esl-epfl/VersaSens/VersaSens_Casing/Design_Compact/Description_Design_Compact.txt

CAD design for the compact casing as STP and STL files.

Recommendation for 3D printing:
- Resolution: 0.15mm
- PLA material
- support on bed only
- Front part on the front face
- Back part on the back face and with an opened latch at 60°.
