esl-epfl/VersaSens/VersaSens_Casing/Design_Distributed/Main_front.stl

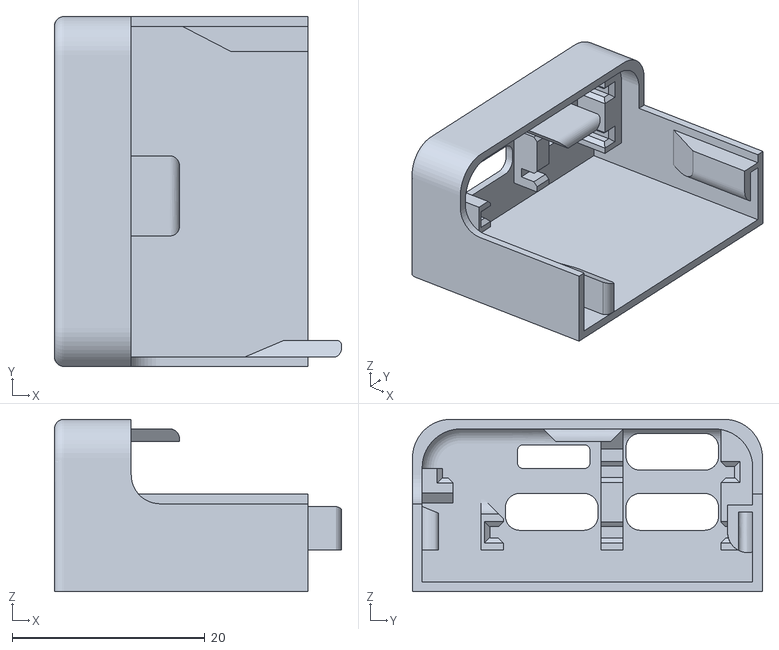
[picture p1: CAD file, 2024-08-30]
VersaSens_Casing/Design_Distributed/Main_front.stl
29.8 x 36.3 x 17.9
