esl-epfl/VersaSens/VersaSens_Casing/Design_Distributed/main_back_latch.stl

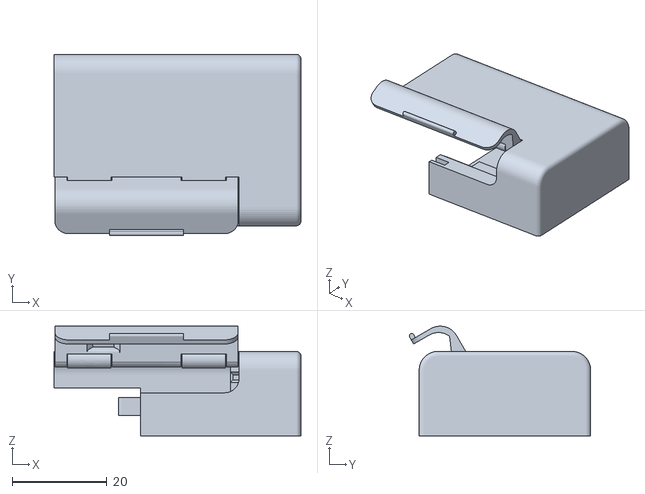
[picture p2: CAD file, 2024-08-30]
VersaSens_Casing/Design_Distributed/main_back_latch.stl
52.2 x 38.4 x 23.2
