esl-epfl/VersaSens/VersaSens_Casing/Design_Compact/VersaSens_Design_Compact_front.stl

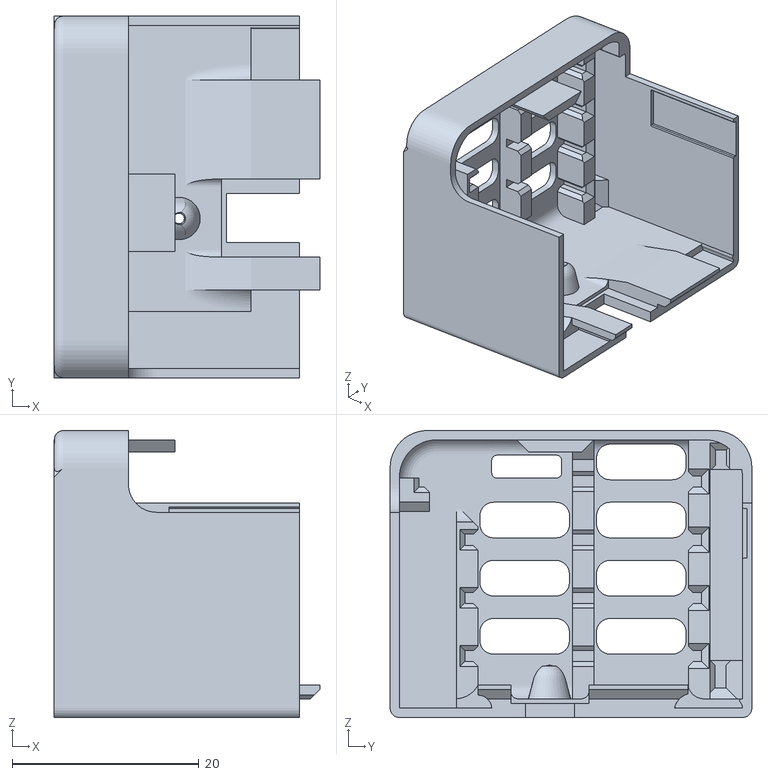
[picture p3: CAD file, 2024-08-30]
VersaSens_Casing/Design_Compact/VersaSens_Design_Compact_front.stl
28.5 x 38.8 x 30.8
