esl-epfl/VersaSens/VersaSens_HW/symbols/BM02B-ACHSS-GAN-TF_LF__SN_/BM02B-ACHSS-GAN-TF_LF__SN_.step

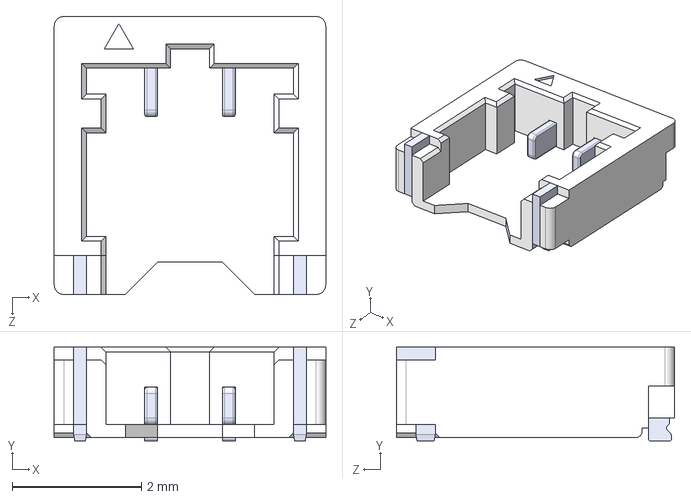
[picture p4: CAD file, 2024-08-30]
VersaSens_HW/symbols/BM02B-ACHSS-GAN-TF_LF__SN_/BM02B-ACHSS-GAN-TF_LF__SN_.step
4.20 x 1.45 x 4.30 mm
