esl-epfl/VersaSens/VersaSens_HW/symbols/USB4055-30-A/USB4055-30-A.step

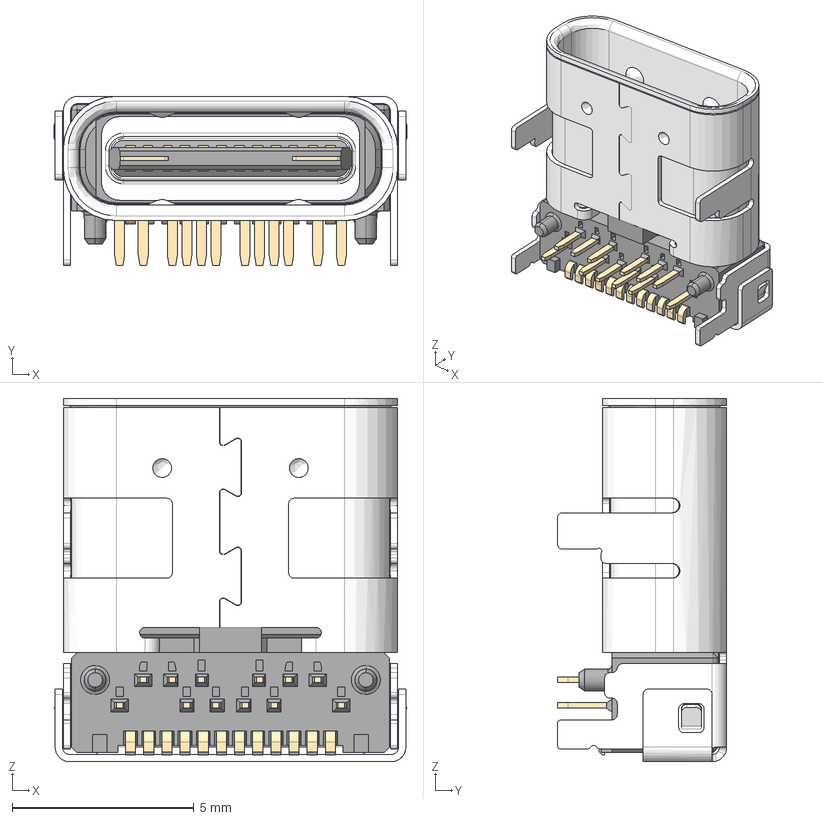
[picture p5: CAD file, 2024-08-30]
VersaSens_HW/symbols/USB4055-30-A/USB4055-30-A.step
9.71 x 4.66 x 10.0 mm
