esl-epfl/VersaSens/VersaSens_Casing/Design_Compact/VersaSens_Design_Compact_back_latch.stl

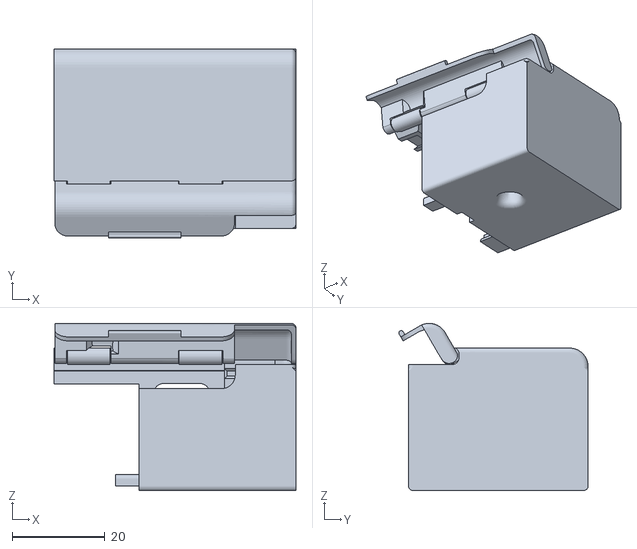
[picture p6: CAD file, 2024-08-30]
VersaSens_Casing/Design_Compact/VersaSens_Design_Compact_back_latch.stl
52.2 x 40.9 x 36.1
