esl-epfl/VersaSens/VersaSens_Casing/Design_Compact/VersaSens_Design_Compact.step

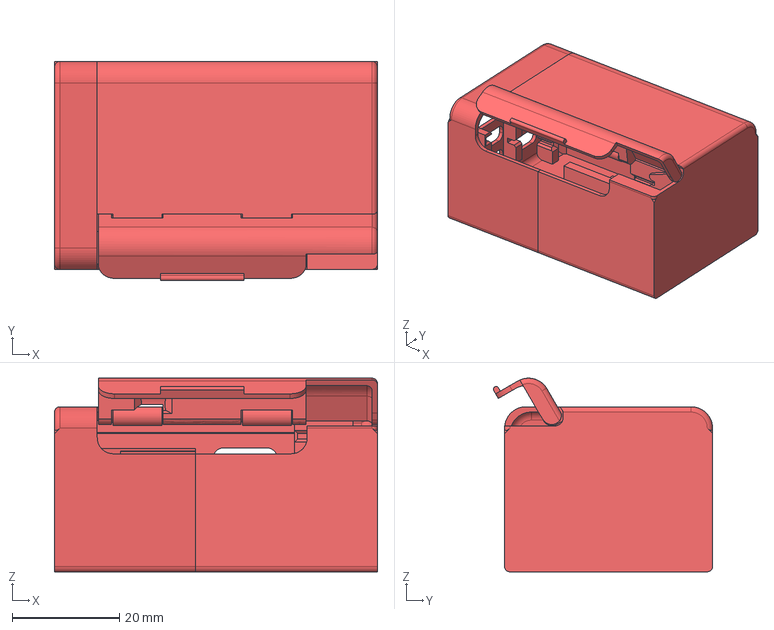
[picture p7: CAD file, 2024-08-30]
VersaSens_Casing/Design_Compact/VersaSens_Design_Compact.step
60.2 x 40.9 x 36.1 mm
Frame1
Frame2
