esl-epfl/VersaSens/VersaSens_Casing/Design_Distributed/VersaSens_Design_Distributed_.step

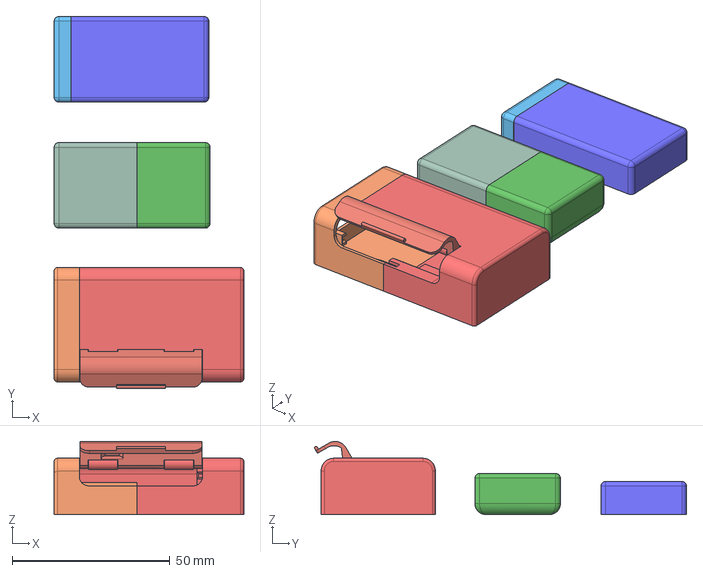
[picture p8: CAD file, 2024-08-30]
VersaSens_Casing/Design_Distributed/VersaSens_Design_Distributed_.step
60.2 x 118.1 x 23.2 mm
