esl-epfl/VersaSens/VersaSens_Casing/Design_Distributed/PPG_back.stl

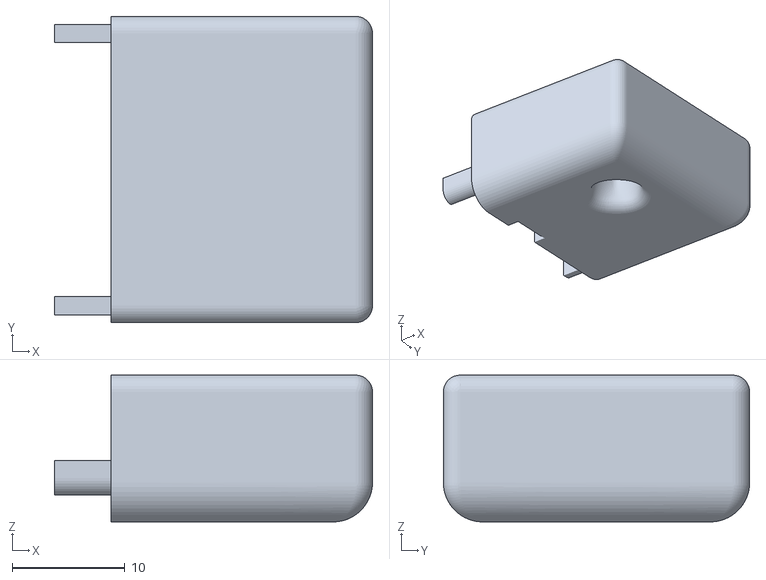
[picture p9: CAD file, 2024-08-30]
VersaSens_Casing/Design_Distributed/PPG_back.stl
28.2 x 27.2 x 13.0
