esl-epfl/VersaSens/VersaSens_Casing/Design_Distributed/EDA_back.stl

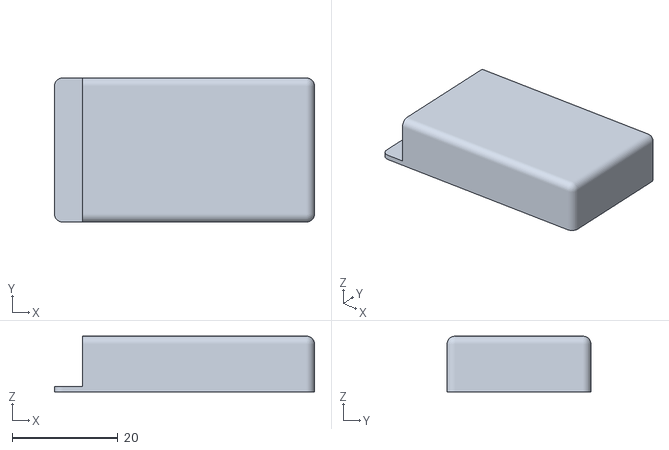
[picture p10: CAD file, 2024-08-30]
VersaSens_Casing/Design_Distributed/EDA_back.stl
49.1 x 27.2 x 10.5
