esl-epfl/VersaSens/VersaSens_Casing/Design_Distributed/PPG_front.stl

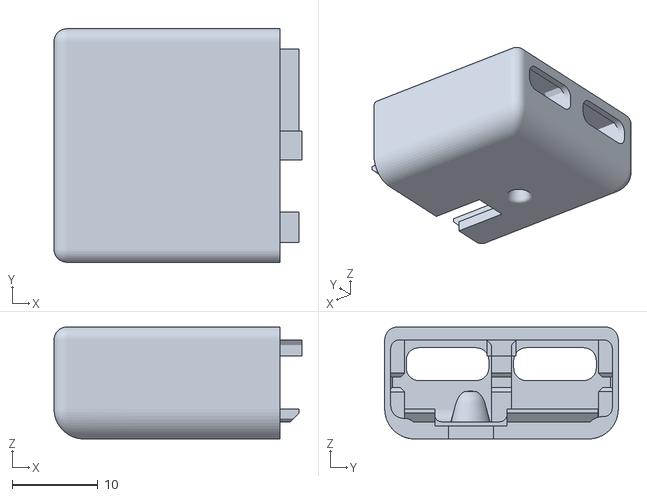
[picture p11: CAD file, 2024-08-30]
VersaSens_Casing/Design_Distributed/PPG_front.stl
28.8 x 27.2 x 13.0
