esl-epfl/VersaSens/VersaSens_Casing/Design_Distributed/EDA_front.stl

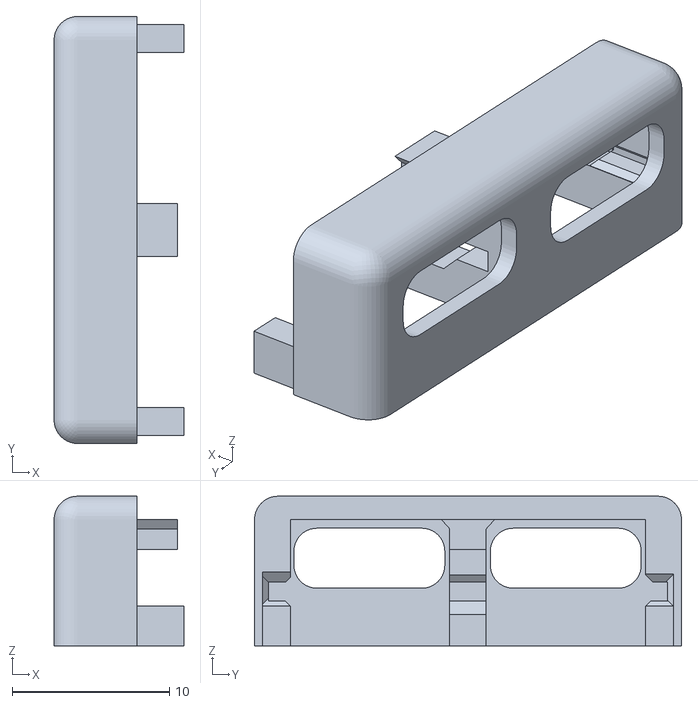
[picture p12: CAD file, 2024-08-30]
VersaSens_Casing/Design_Distributed/EDA_front.stl
8.27 x 27.2 x 9.53
