esl-epfl/VersaSens/VersaSens_HW/symbols/47589-0001/47589-0001.step

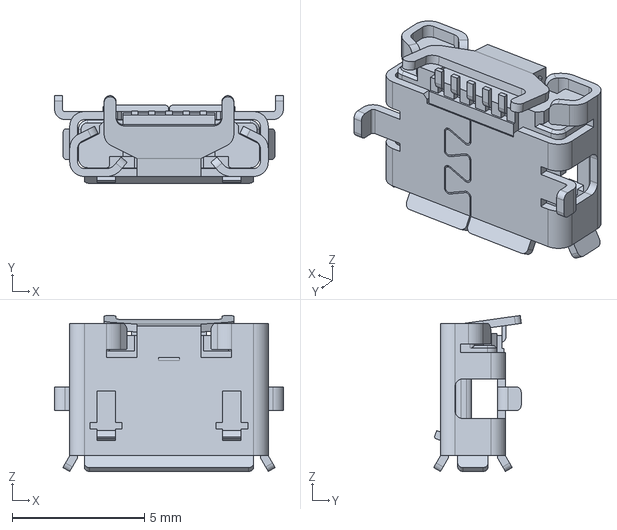
[picture p13: CAD file, 2024-08-30]
VersaSens_HW/symbols/47589-0001/47589-0001.step
8.65 x 3.31 x 5.89 mm
