esl-epfl/VersaSens/(threads)

Thread 2 (2024-09-06):

Main-Module_MAX77658BANX+T

JoseCalero, 2024-09-06:
Problem: MAX77658BANX+T has the SBB2 off by default. SBB2 is the main supply (3.3V) of the board. SBB2 can be activated changing register EN_SBB2 of MAX77658BANX+T by nRF5340. But the nRF5340 is supplied by the SBB2.

Temporary solution: A jumper to be applied on the board from C6 (V-SYS) to pin1 of IC3. Once the microcontroller is supplied, the ADE_SBB2 register should be disabled from the software (ADE_SBB2 = 0b0) to disable the discharge resistors on the SBB2.

Picture:
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
