esl-epfl/VersaSens/VersaSens_HW/ECG_PPG.kicad_sch

## KiCad design VersaSens_HW/ECG_PPG.kicad_sch (2024-08-30)

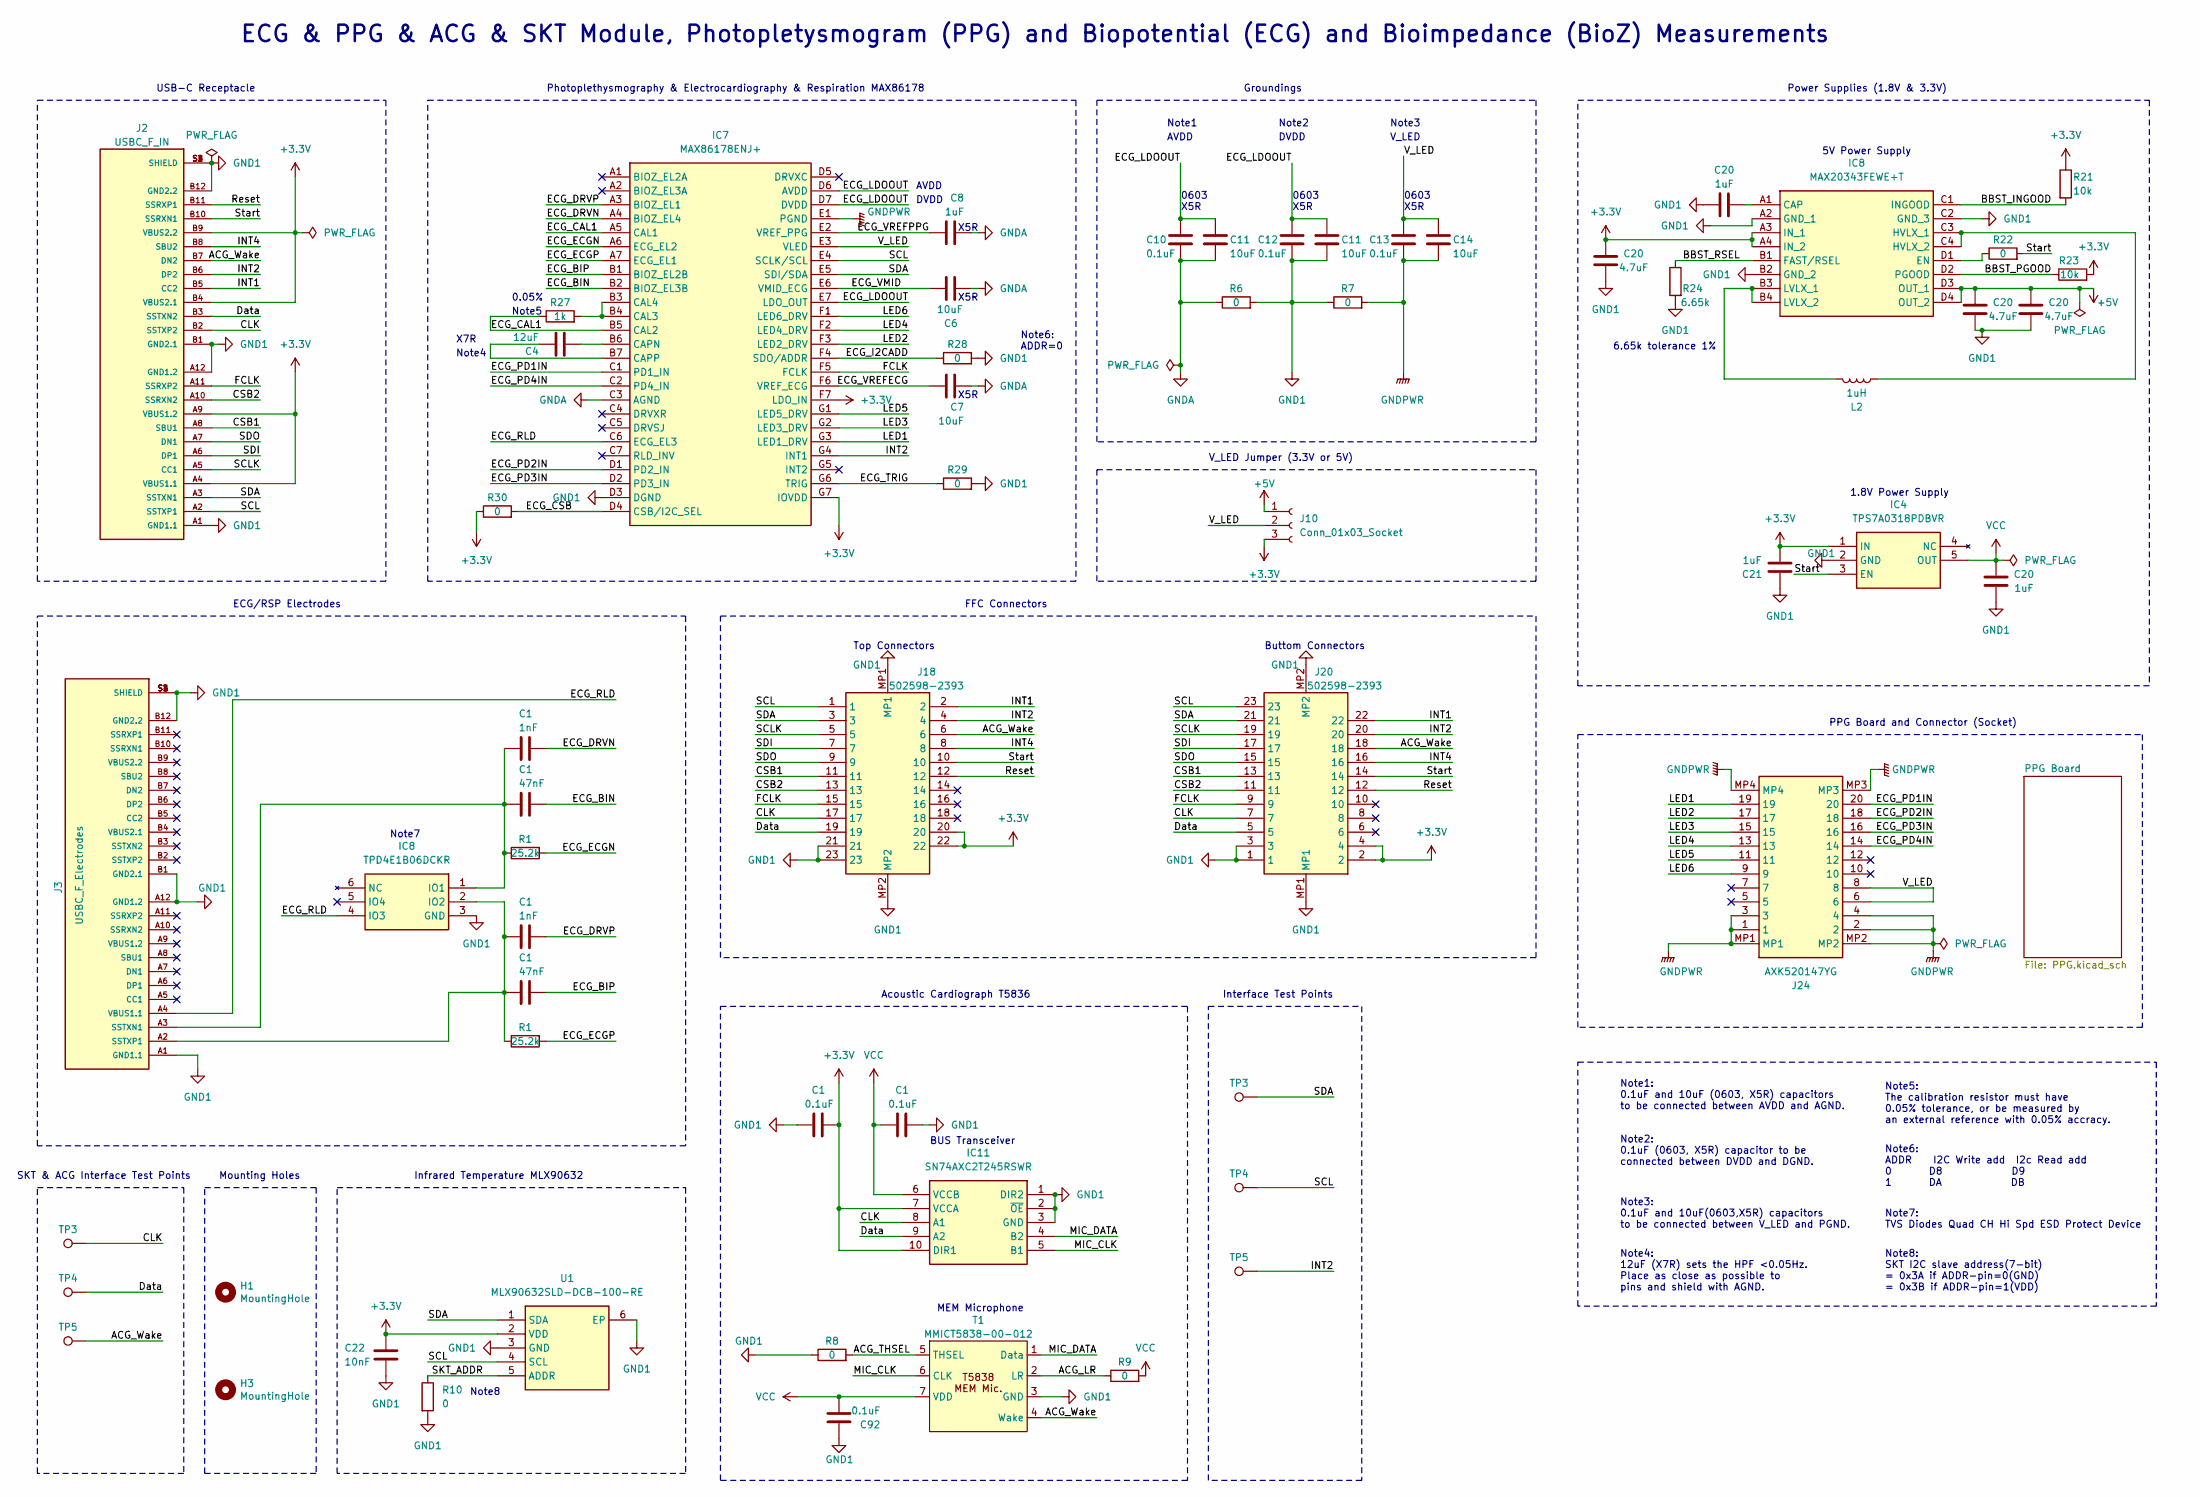
[picture p14: schematic ECG_PPG.kicad_sch]

Parts:
C1: 1nF; C_0603_1608Metric
C4: 12uF; C_1210_3225Metric
C6, C7, C11, C14: 10uF; C_0603_1608Metric
C8: 1uF; C_0603_1608Metric
C10, C12, C13: 0.1uF; C_0603_1608Metric
C20: 4.7uF; C_0402_1005Metric
C21: 1uF; C_0402_1005Metric
C22: 10nF; C_0603_1608Metric
C92: 0.1uF; C_0402_1005Metric
H1, H3: MountingHole; MountingHole_2.5mm
IC4: TPS7A0318PDBVR; SOT95P280X145-5N; Mouser Part Number 595-TPS7A0318PDBVR
IC7: MAX86178ENJ+; 21-100520_N492A2&plus_1_MXM; Manufacturer_Part_Number MAX86178ENJ+; Mouser Part Number N/A
IC8: MAX20343FEWE+T; BGA16C40P4X4_201X177X69; Manufacturer_Part_Number MAX20343FEWE+T; Mouser Part Number 700-MAX20343FEWE+T
IC11: SN74AXC2T245RSWR; Mouser Part Number 595-SN74AXC2T245RSWR
J2: USBC_F_IN; GCT_USB4055-30-A; PARTREV B; DIGI-KEY_PART_NUMBER 2073-USB4055-30-ACT-ND
J3: USBC_F_Electrodes; GCT_USB4055-30-A; PARTREV B; DIGI-KEY_PART_NUMBER 2073-USB4055-30-ACT-ND
J10: Conn_01x03_Socket; HDRV3W40P0X127_1X3_381X210X430P
J18, J20: 502598-2393; 5025982393; Mouser Part Number 538-502598-2393
J24: AXK520147YG; Mouser Part Number 769-AXK520147YG
L2: 1uH; LQM21PN1R0MEHD
R1: 25.2k; R_0402_1005Metric
R6, R7, R8, R9, R10, R22, R28, R29, R30: 0; R_0402_1005Metric
R21, R23: 10k; R_0402_1005Metric
R24: 6.65k; R_0402_1005Metric
R27: 1k; R_0402_1005Metric
T1: MMICT5838-00-012; LGA_CAV5_IVS
TP3, TP4, TP5: TestPoint; TestPoint_Pad_D1.0mm
U1: MLX90632SLD-DCB-100-RE; MLX90632SLDDCB100RE; Manufacturer_Part_Number MLX90632SLD-DCB-100-RE; Mouser Part Number 482-90632SLDDCB100RE

Connections:
+3.3V: C1.1, C20.1, C21.2, C22.1, IC4.1 (IN), IC7.F7 (LDO_IN), IC7.G7 (IOVDD), IC8.A3 (IN_1), IC8.A4 (IN_2), IC11.7 (VCCA), IC11.10 (DIR1), J2.A4 (VBUS1.1), J2.A9 (VBUS1.2), J2.B4 (VBUS2.1), J2.B9 (VBUS2.2), J10.3, J18.20, J18.22, J20.2, J20.4, R21.1, R23.2, R30.1, U1.2 (VDD)
+5V: C20.1, IC8.D3 (OUT_1), IC8.D4 (OUT_2), J10.1
ACG_LR: R9.1, T1.2 (LR)
ACG_THSEL: R8.2, T1.5 (THSEL)
ACG_Wake: J2.B7 (DN2), J18.6, J20.18, T1.4 (Wake), TP5.1
BBST_INGOOD: IC8.C1 (INGOOD), R21.2
BBST_PGOOD: IC8.D2 (PGOOD), R23.1
BBST_RSEL: IC8.B1 (FAST/RSEL), R24.1
CLK: IC11.8 (A1), J2.B2 (SSTXP2), J18.17, J20.7, TP3.1
CSB1: J2.A8 (SBU1), J18.11, J20.13
CSB2: J2.A10 (SSRXN2), J18.13, J20.11
Data: IC11.9 (A2), J2.B3 (SSTXN2), J18.19, J20.5, TP4.1
ECG_BIN: C1.1, IC7.B2 (BIOZ_EL3B)
ECG_BIP: C1.1, IC7.B1 (BIOZ_EL2B)
ECG_CAL1: IC7.A5 (CAL1), IC7.B5 (CAL2), R27.1
ECG_CSB: IC7.D4 (CSB/I2C_SEL), R30.2
ECG_DRVN: C1.1, IC7.A4 (BIOZ_EL4)
ECG_DRVP: C1.1, IC7.A3 (BIOZ_EL1)
ECG_ECGN: IC7.A6 (ECG_EL2), R1.2
ECG_ECGP: IC7.A7 (ECG_EL1), R1.2
ECG_I2CADD: IC7.F4 (SDO/ADDR), R28.1
ECG_LDOOUT: C10.1, C11.1, C12.1, IC7.D6 (AVDD), IC7.D7 (DVDD), IC7.E7 (LDO_OUT)
ECG_PD1IN: IC7.C1 (PD1_IN), J24.20
ECG_PD2IN: IC7.D1 (PD2_IN), J24.18
ECG_PD3IN: IC7.D2 (PD3_IN), J24.16
ECG_PD4IN: IC7.C2 (PD4_IN), J24.14
ECG_RLD: IC7.C6 (ECG_EL3), IC8.4 (IO3), J3.A4 (VBUS1.1)
ECG_TRIG: IC7.G6 (TRIG), R29.1
ECG_VMID: C6.2, IC7.E6 (VMID_ECG)
ECG_VREFECG: C7.1, IC7.F6 (VREF_ECG)
ECG_VREFPPG: C8.1, IC7.E2 (VREF_PPG)
FCLK: IC7.F5 (FCLK), J2.A11 (SSRXP2), J18.15, J20.9
GND1: C1.1, C1.2, C11.2, C12.2, C20.2, C21.1, C22.2, C92.2, IC4.2 (GND), IC7.D3 (DGND), IC8.3 (GND), IC8.A2 (GND_1), IC8.B2 (GND_2), IC8.C2 (GND_3), IC11.1 (DIR2), IC11.2 (~OE), IC11.3 (GND), J2.A1 (GND1.1), J2.A12 (GND1.2), J2.B1 (GND2.1), J2.B12 (GND2.2), J2.S1 (SHIELD), J2.S2 (SHIELD), J2.S3 (SHIELD), J2.S4 (SHIELD), J3.A1 (GND1.1), J3.A12 (GND1.2), J3.B1 (GND2.1), J3.B12 (GND2.2), J3.S1 (SHIELD), J3.S2 (SHIELD), J3.S3 (SHIELD), J3.S4 (SHIELD), J18.21, J18.23, J18.MP1, J18.MP2, J20.1, J20.3, J20.MP1, J20.MP2, R6.2, R7.1, R8.1, R10.2, R24.2, R28.2, R29.2, T1.3 (GND), U1.3 (GND), U1.6 (EP)
GNDA: C6.1, C7.2, C8.2, C10.2, C11.2, IC7.C3 (AGND), R6.1
GNDPWR: C13.2, C14.2, IC7.E1 (PGND), J24.1, J24.2, J24.3, J24.4, J24.MP1, J24.MP2, J24.MP3, J24.MP4, R7.2
INT1: J2.B5 (CC2), J18.2, J20.22
INT2: IC7.G4 (INT1), J2.B6 (DP2), J18.4, J20.20, TP5.1
INT4: J2.B8 (SBU2), J18.8, J20.16
LED1: IC7.G3 (LED1_DRV), J24.19
LED2: IC7.F3 (LED2_DRV), J24.17
LED3: IC7.G2 (LED3_DRV), J24.15
LED4: IC7.F2 (LED4_DRV), J24.13
LED5: IC7.G1 (LED5_DRV), J24.11
LED6: IC7.F1 (LED6_DRV), J24.9
MIC_CLK: IC11.5 (B1), T1.6 (CLK)
MIC_DATA: IC11.4 (B2), T1.1 (Data)
unnamed: C1.2, IC8.1 (IO1), IC8.2 (IO2), J3.A2 (SSTXP1), J3.A3 (SSTXN1), R1.1
unnamed: C4.1, IC7.B7 (CAPP)
unnamed: C4.2, IC7.B6 (CAPN)
unnamed: C20.1, IC8.A1 (CAP)
unnamed: IC7.B3 (CAL4), IC7.B4 (CAL3), R27.2
unnamed: IC8.B3 (LVLX_1), IC8.B4 (LVLX_2), L2.1
unnamed: IC8.C3 (HVLX_1), IC8.C4 (HVLX_2), L2.2
unnamed: IC8.D1 (EN), R22.1
Reset: J2.B11 (SSRXP1), J18.12, J20.12
SCL: IC7.E4 (SCLK/SCL), J2.A2 (SSTXP1), J18.1, J20.23, TP4.1, U1.4 (SCL)
SCLK: J2.A5 (CC1), J18.5, J20.19
SDA: IC7.E5 (SDI/SDA), J2.A3 (SSTXN1), J18.3, J20.21, TP3.1, U1.1 (SDA)
SDI: J2.A6 (DP1), J18.7, J20.17
SDO: J2.A7 (DN1), J18.9, J20.15
SKT_ADDR: R10.1, U1.5 (ADDR)
Start: IC4.3 (EN), J2.B10 (SSRXN1), J18.10, J20.14, R22.2
VCC: C1.2, C20.1, C92.1, IC4.5 (OUT), IC11.6 (VCCB), R9.2, T1.7 (VDD)
V_LED: C13.1, C14.1, IC7.E3 (VLED), J10.2, J24.6, J24.8

Notes on the sheet:
X5R
Interface Test Points
Note8
Note5: The calibration resistor must have 0.05% tolerance, or be measured by an external reference with 0.05% accracy.
6.65k tolerance 1%
ECG/RSP Electrodes
V_LED
Note3: 0.1uF and 10uF(0603,X5R) capacitors to be connected between V_LED and PGND.
Note6: ADDR=0
Photoplethysmography & Electrocardiography & Respiration MAX86178
0603 X5R
BUS Transceiver
Note4
Note8: SKT I2C slave address(7-bit) = 0x3A if ADDR-pin=0(GND) = 0x3B if ADDR-pin=1(VDD)
Note2
AVDD
Top Connectors
V_LED Jumper (3.3V or 5V)
SKT & ACG Interface Test Points
MEM Microphone
Note7: TVS Diodes Quad CH Hi Spd ESD Protect Device
Note1: 0.1uF and 10uF (0603, X5R) capacitors to be connected between AVDD and AGND.
USB-C Receptacle
Infrared Temperature MLX90632
ECG & PPG & ACG & SKT Module, Photopletysmogram (PPG) and Biopotential (ECG) and Bioimpedance (BioZ) Measurements
1.8V Power Supply
Note7
Note5
Note1
DVDD
Buttom Connectors
FFC Connectors
0.05%
Note4: 12uF (X7R) sets the HPF <0.05Hz. Place as close as possible to pins and shield with AGND.
Groundings
Power Supplies (1.8V & 3.3V)
Note2: 0.1uF (0603, X5R) capacitor to be connected between DVDD and DGND.
5V Power Supply
Note6: ADDR I2C Write add I2c Read add 0 D8 D9 1 DA DB
Mounting Holes
Acoustic Cardiograph T5836
Note3
PPG Board and Connector (Socket)
X7R
