esl-epfl/VersaSens/VersaSens_HW/EDA.kicad_sch

## KiCad design VersaSens_HW/EDA.kicad_sch (2024-08-30)

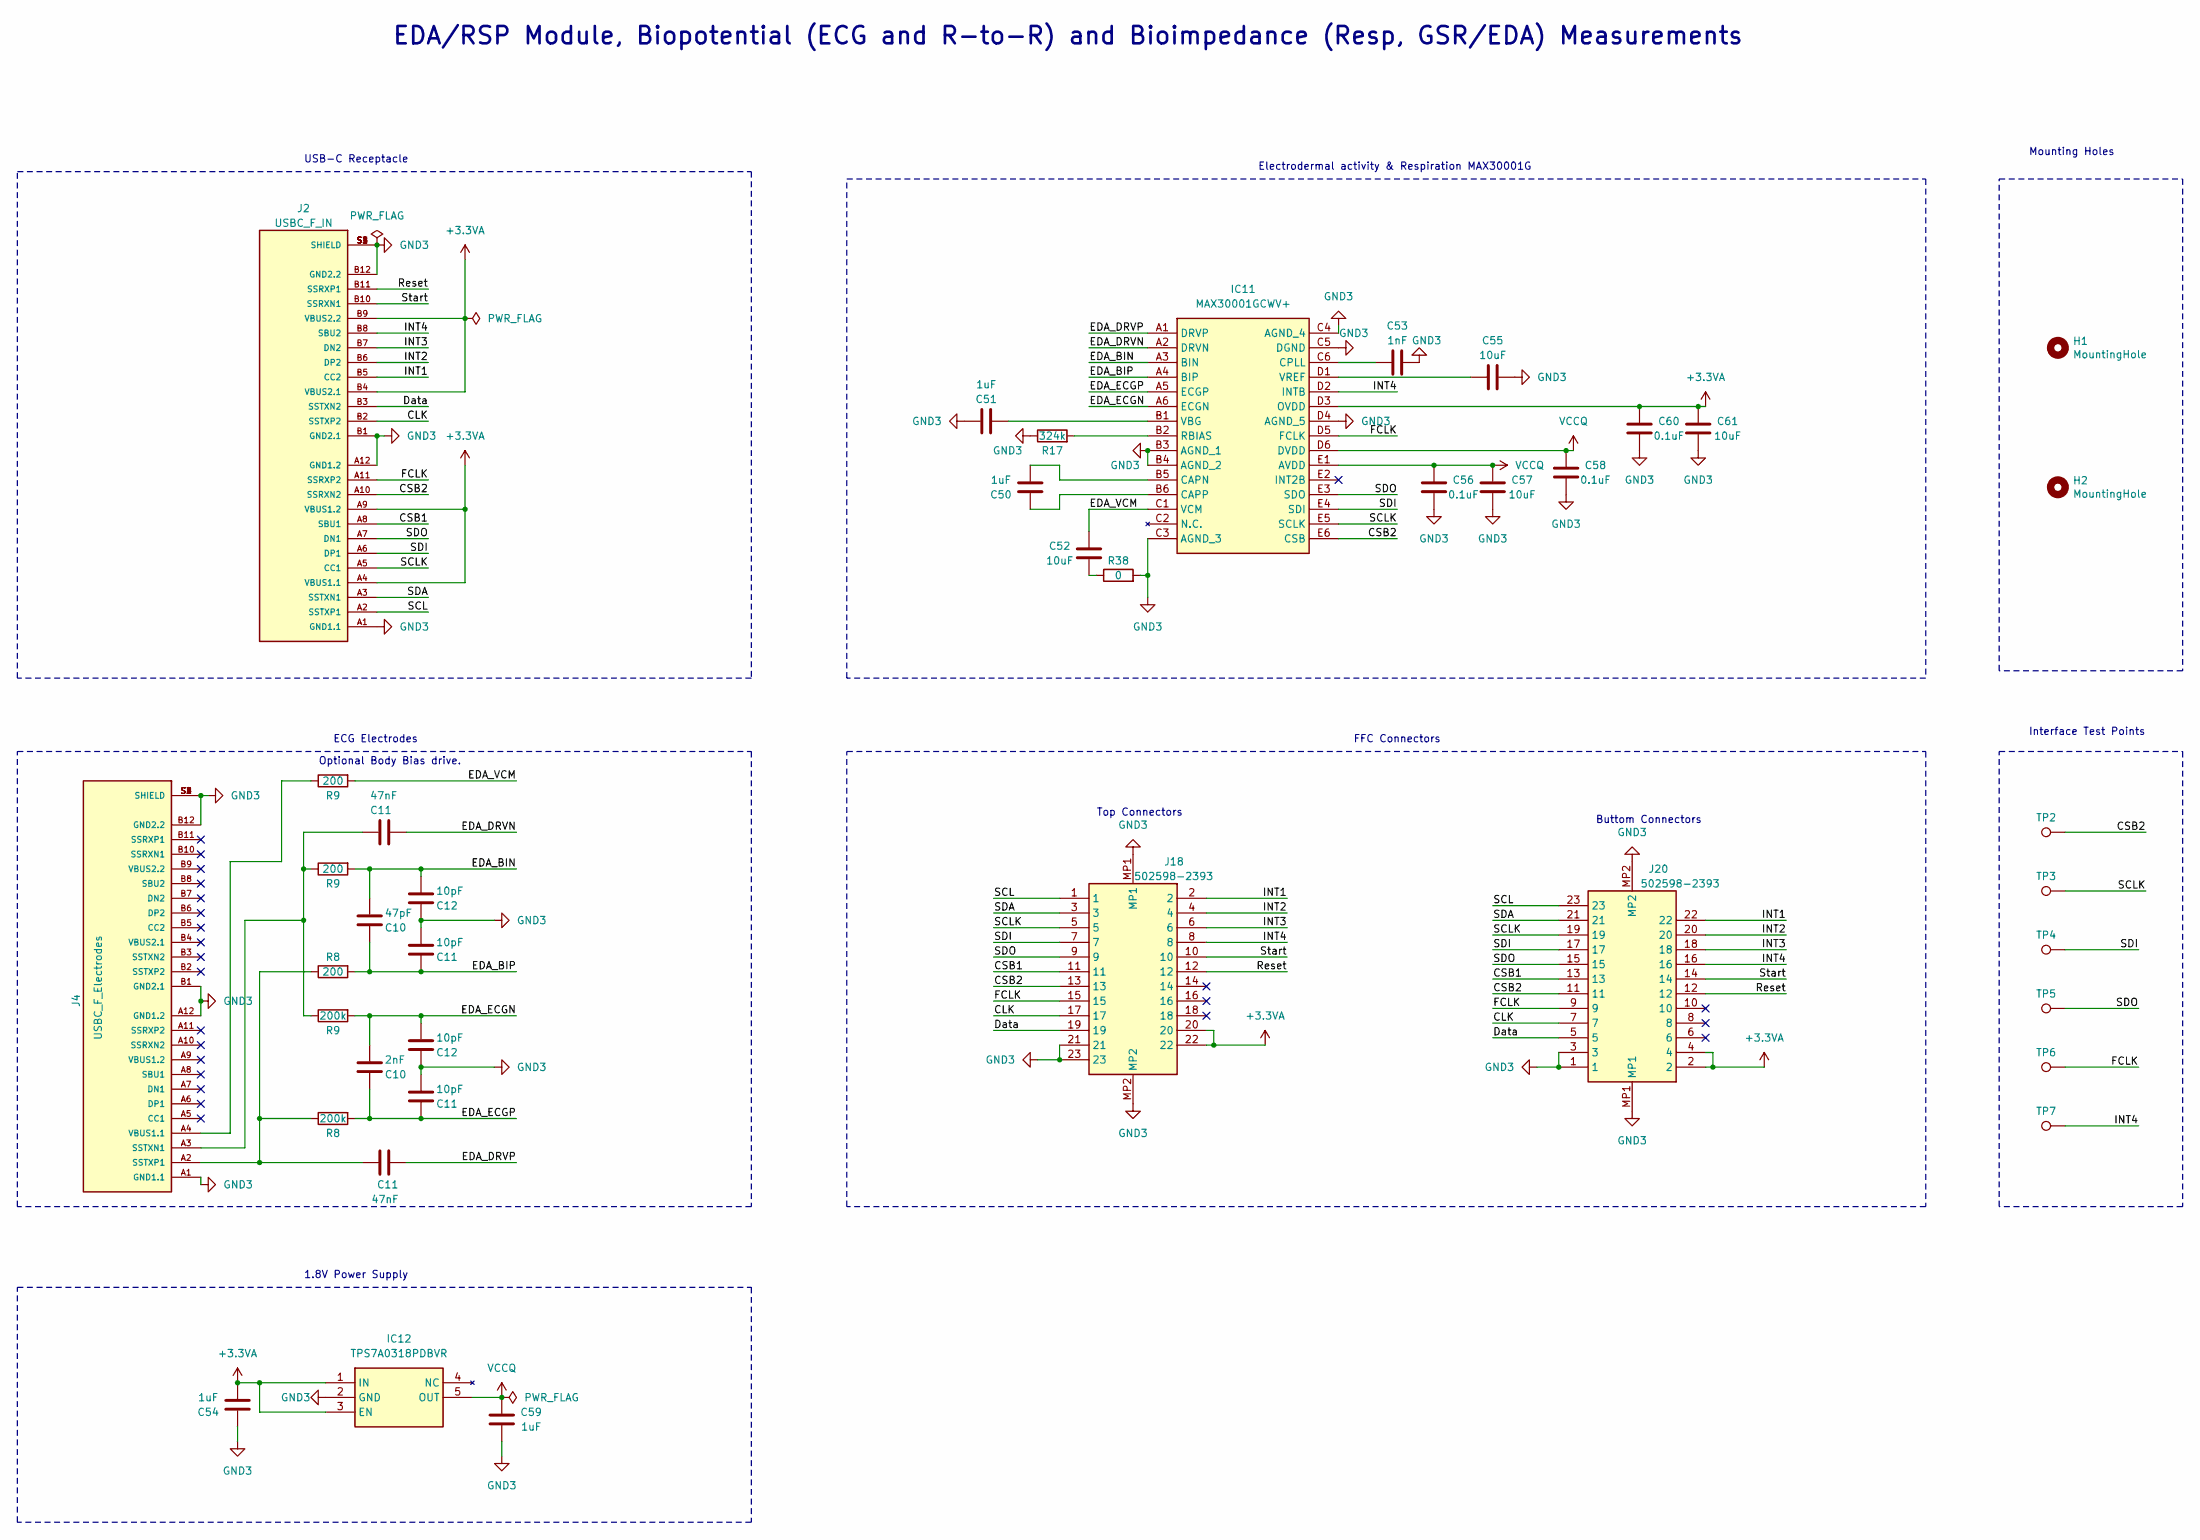
[picture p15: schematic EDA.kicad_sch]

Parts:
C10: 47pF; C_0603_1608Metric
C11, C12: 10pF; C_0603_1608Metric
C50, C51, C54, C59: 1uF; C_0402_1005Metric
C52, C55, C57, C61: 10uF; C_0603_1608Metric
C53: 1nF; C_0402_1005Metric
C56, C58, C60: 0.1uF; C_0402_1005Metric
H1, H2: MountingHole; MountingHole_2.5mm
IC11: MAX30001GCWV+; BGA30C50P6X5_293X274X69; Manufacturer_Part_Number MAX30001GCWV+; Mouser Part Number 700-MAX30001GCWV+
IC12: TPS7A0318PDBVR; SOT95P280X145-5N; Mouser Part Number 595-TPS7A0318PDBVR
J2: USBC_F_IN; GCT_USB4055-30-A; PARTREV B; DIGI-KEY_PART_NUMBER 2073-USB4055-30-ACT-ND
J4: USBC_F_Electrodes; GCT_USB4055-30-A; PARTREV B; DIGI-KEY_PART_NUMBER 2073-USB4055-30-ACT-ND
J18, J20: 502598-2393; 5025982393; Mouser Part Number 538-502598-2393
R8: 200k; R_0402_1005Metric
R9: 200; R_0402_1005Metric
R17: 324k; R_0402_1005Metric
R38: 0; R_0402_1005Metric
TP2, TP3, TP4, TP5, TP6, TP7: TestPoint; TestPoint_Pad_D1.0mm

Connections:
+3.3VA: C54.2, C60.1, C61.1, IC11.D3 (OVDD), IC12.1 (IN), IC12.3 (EN), J2.A4 (VBUS1.1), J2.A9 (VBUS1.2), J2.B4 (VBUS2.1), J2.B9 (VBUS2.2), J18.20, J18.22, J20.2, J20.4
CLK: J2.B2 (SSTXP2), J18.17, J20.7
CSB1: J2.A8 (SBU1), J18.11, J20.13
CSB2: IC11.E6 (CSB), J2.A10 (SSRXN2), J18.13, J20.11, TP2.1
Data: J2.B3 (SSTXN2), J18.19, J20.5
EDA_BIN: C10.2, C12.1, IC11.A3 (BIN), R9.2
EDA_BIP: C10.1, C11.1, IC11.A4 (BIP), R8.2
EDA_DRVN: C11.1, IC11.A2 (DRVN)
EDA_DRVP: C11.2, IC11.A1 (DRVP)
EDA_ECGN: C10.2, C12.1, IC11.A6 (ECGN), R9.2
EDA_ECGP: C10.1, C11.1, IC11.A5 (ECGP), R8.2
EDA_VCM: C52.1, IC11.C1 (VCM), R9.2
FCLK: IC11.D5 (FCLK), J2.A11 (SSRXP2), J18.15, J20.9, TP6.1
GND3: C11.2, C12.2, C51.2, C53.2, C54.1, C55.2, C56.2, C57.2, C58.2, C59.2, C60.2, C61.2, IC11.B3 (AGND_1), IC11.B4 (AGND_2), IC11.C3 (AGND_3), IC11.C4 (AGND_4), IC11.C5 (DGND), IC11.D4 (AGND_5), IC12.2 (GND), J2.A1 (GND1.1), J2.A12 (GND1.2), J2.B1 (GND2.1), J2.B12 (GND2.2), J2.S1 (SHIELD), J2.S2 (SHIELD), J2.S3 (SHIELD), J2.S4 (SHIELD), J4.A1 (GND1.1), J4.A12 (GND1.2), J4.B1 (GND2.1), J4.B12 (GND2.2), J4.S1 (SHIELD), J4.S2 (SHIELD), J4.S3 (SHIELD), J4.S4 (SHIELD), J18.21, J18.23, J18.MP1, J18.MP2, J20.1, J20.3, J20.MP1, J20.MP2, R17.1, R38.2
INT1: J2.B5 (CC2), J18.2, J20.22
INT2: J2.B6 (DP2), J18.4, J20.20
INT3: J2.B7 (DN2), J18.6, J20.18
INT4: IC11.D2 (INTB), J2.B8 (SBU2), J18.8, J20.16, TP7.1
unnamed: C11.1, J4.A2 (SSTXP1), R8.1
unnamed: C11.2, J4.A3 (SSTXN1), R9.1
unnamed: C50.1, IC11.B6 (CAPP)
unnamed: C50.2, IC11.B5 (CAPN)
unnamed: C51.1, IC11.B1 (VBG)
unnamed: C52.2, R38.1
unnamed: C53.1, IC11.C6 (CPLL)
unnamed: C55.1, IC11.D1 (VREF)
unnamed: IC11.B2 (RBIAS), R17.2
unnamed: J4.A4 (VBUS1.1), R9.1
Reset: J2.B11 (SSRXP1), J18.12, J20.12
SCL: J2.A2 (SSTXP1), J18.1, J20.23
SCLK: IC11.E5 (SCLK), J2.A5 (CC1), J18.5, J20.19, TP3.1
SDA: J2.A3 (SSTXN1), J18.3, J20.21
SDI: IC11.E4 (SDI), J2.A6 (DP1), J18.7, J20.17, TP4.1
SDO: IC11.E3 (SDO), J2.A7 (DN1), J18.9, J20.15, TP5.1
Start: J2.B10 (SSRXN1), J18.10, J20.14
VCCQ: C56.1, C57.1, C58.1, C59.1, IC11.D6 (DVDD), IC11.E1 (AVDD), IC12.5 (OUT)

Notes on the sheet:
Top Connectors
Interface Test Points
Mounting Holes
USB-C Receptacle
ECG Electrodes
1.8V Power Supply
Electrodermal activity & Respiration MAX30001G
EDA/RSP Module, Biopotential (ECG and R-to-R) and Bioimpedance (Resp, GSR/EDA) Measurements
Buttom Connectors
Optional Body Bias drive.
FFC Connectors
