esl-epfl/VersaSens/VersaSens_HW/EMG.kicad_sch

## KiCad design VersaSens_HW/EMG.kicad_sch (2024-08-30)

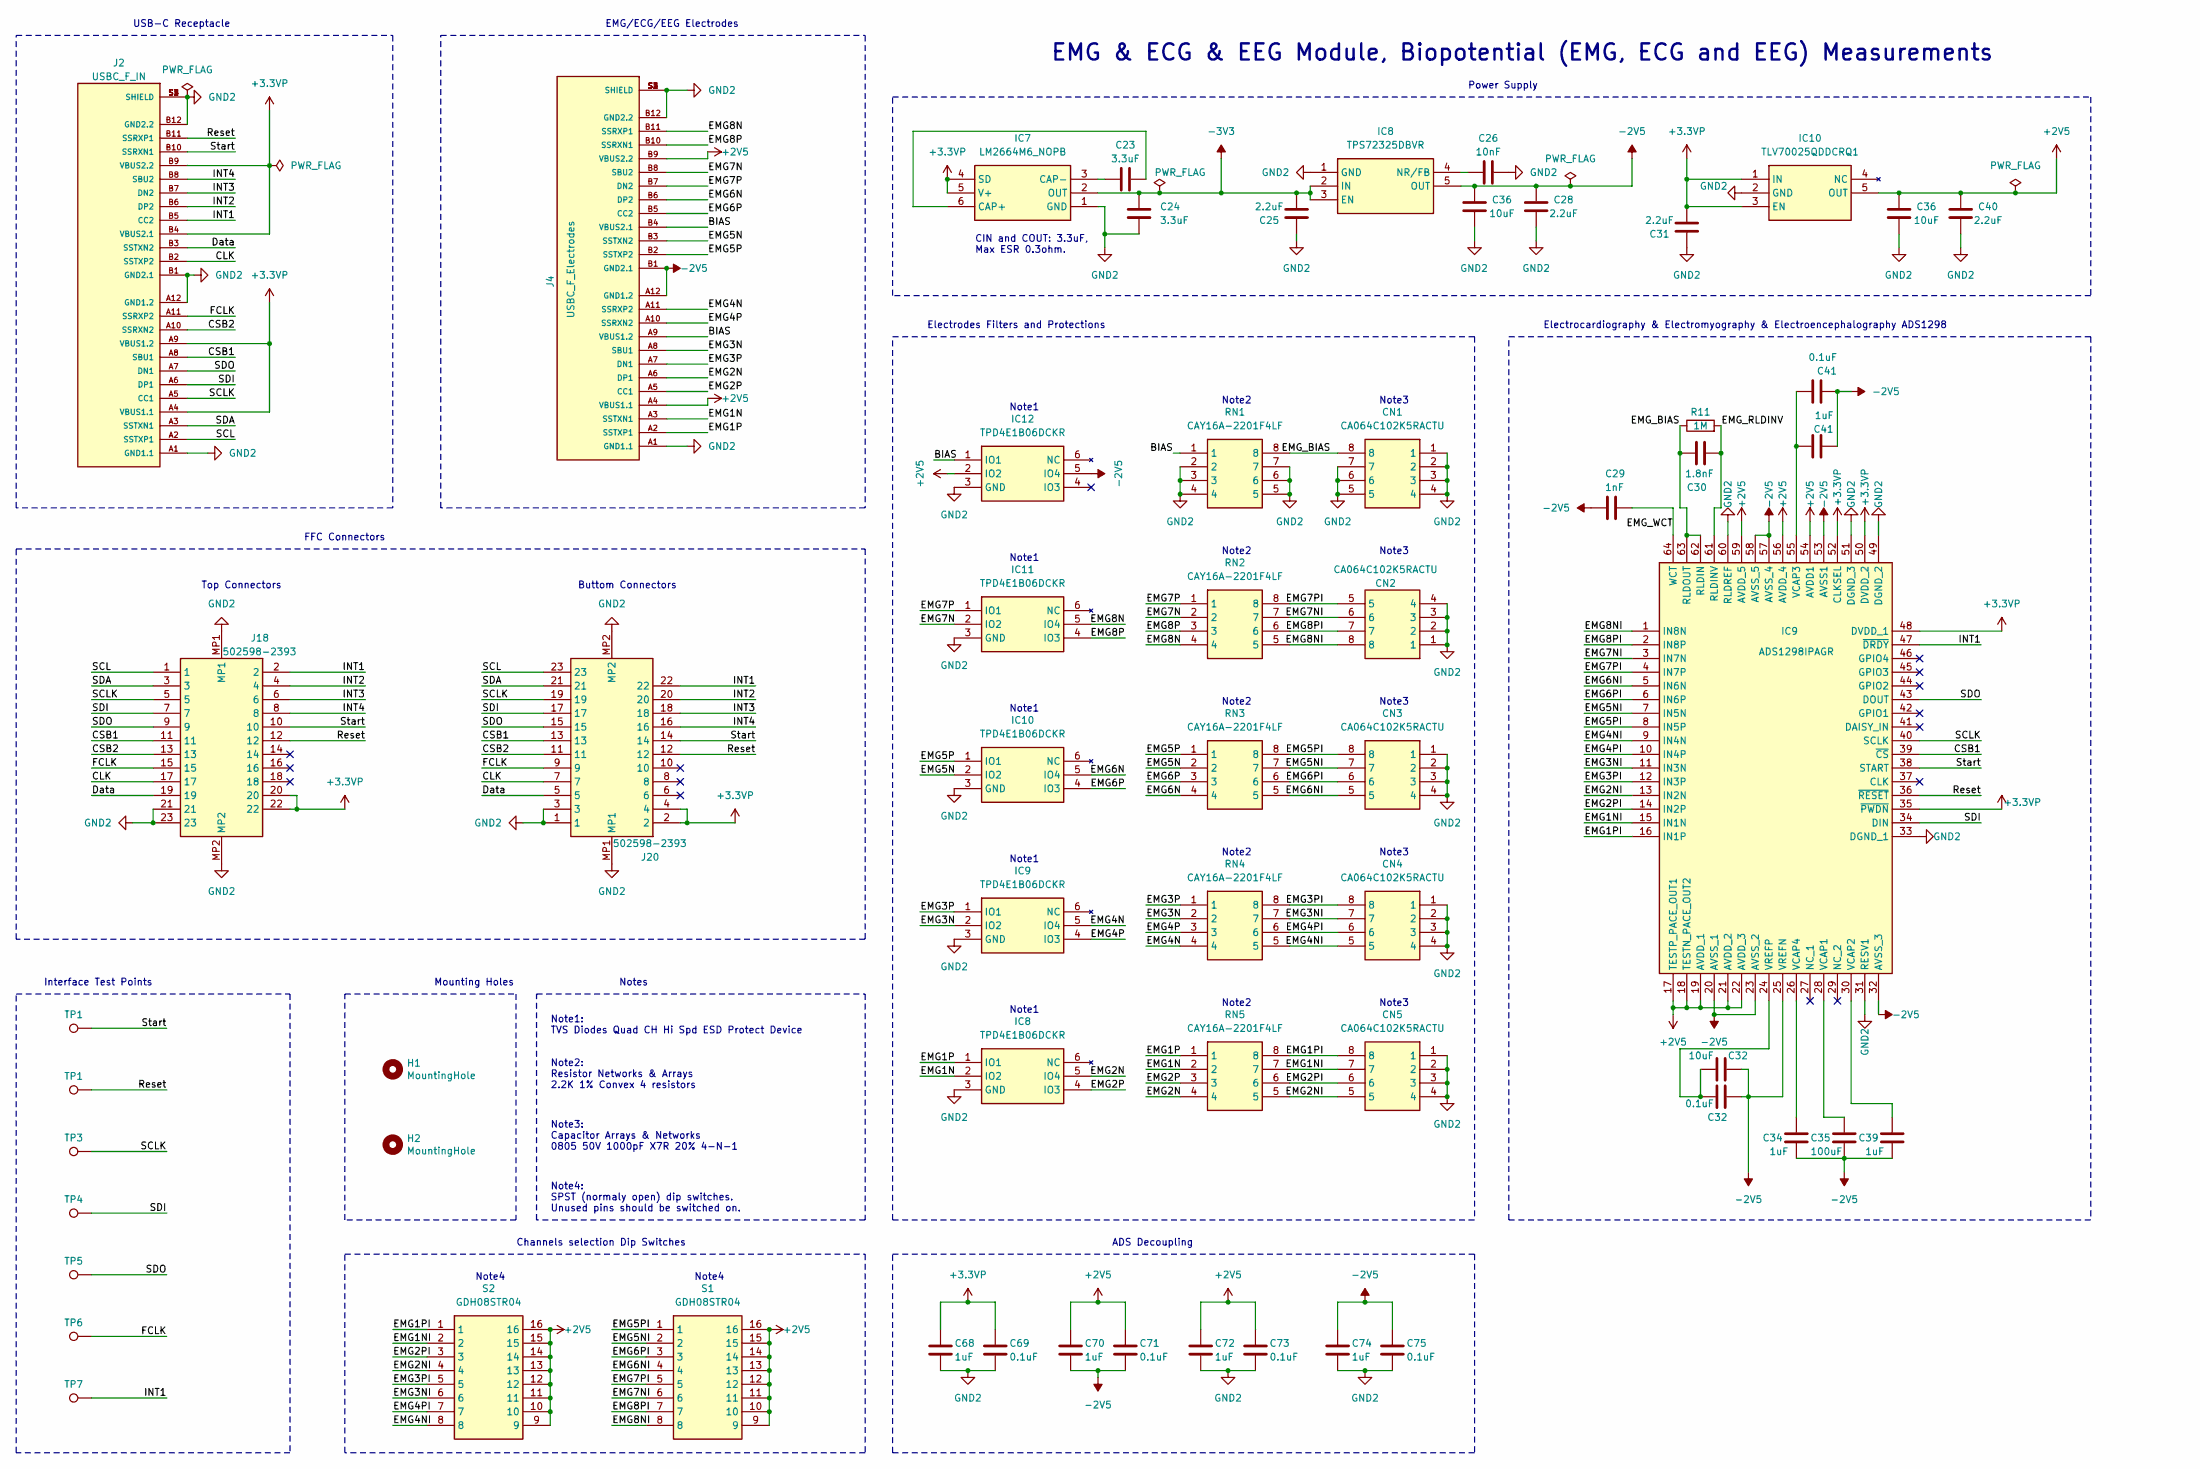
[picture p16: schematic EMG.kicad_sch]

Parts:
C23, C24: 3.3uF; C_0603_1608Metric
C25, C28, C31, C40: 2.2uF; C_0402_1005Metric
C26: 10nF; C_0603_1608Metric
C29: 1nF; C_0402_1005Metric
C30: 1.8nF; C_0402_1005Metric
C32, C69, C71, C73, C75: 0.1uF; C_0402_1005Metric
C34, C39, C41, C68, C70, C72, C74: 1uF; C_0402_1005Metric
C35: 100uF; CAPC3225X279N
C36: 10uF; C_0603_1608Metric
CN1, CN2, CN3, CN4, CN5: CA064C102K5RACTU; Mouser Part Number 80-CA064C102K5R
H1, H2: MountingHole; MountingHole_2.5mm
IC7: LM2664M6_NOPB; SOT95P280X145-6N; Mouser Part Number 926-LM2664M6/NOPB
IC8: TPS72325DBVR; SOT95P280X145-5N; Mouser Part Number 595-TPS72301DBVR
IC9, IC11, IC12: TPD4E1B06DCKR; SOT65P210X110-6N; Mouser Part Number 595-TPD4E1B06DCKR
IC10: TLV70025QDDCRQ1; SOT95P280X110-5N; Mouser Part Number 595-TLV70025QDDCRQ1
J2: USBC_F_IN; GCT_USB4055-30-A; PARTREV B; DIGI-KEY_PART_NUMBER 2073-USB4055-30-ACT-ND
J4: USBC_F_Electrodes; GCT_USB4055-30-A; PARTREV B; DIGI-KEY_PART_NUMBER 2073-USB4055-30-ACT-ND
J18, J20: 502598-2393; 5025982393; Mouser Part Number 538-502598-2393
R11: 1M; R_0402_1005Metric
RN1, RN2, RN3, RN4, RN5: CAY16A-2201F4LF; CAY16A2201F4LF; Mouser Part Number 652-CAY16A-2201F4LF
S1, S2: GDH08STR04; Mouser Part Number 506-GDH08STR04
TP1, TP3, TP4, TP5, TP6, TP7: TestPoint; TestPoint_Pad_D1.0mm

Connections:
+2V5: C36.1, C40.1, C70.1, C71.1, C72.1, C73.1, IC9.17 (TESTP_PACE_OUT1), IC9.18 (TESTN_PACE_OUT2), IC9.19 (AVDD_1), IC9.21 (AVDD_2), IC9.22 (AVDD_3), IC9.54 (AVDD1), IC9.56 (AVDD_4), IC9.59 (AVDD_5), IC10.5 (IO4), IC12.2 (IO2), J4.A4 (VBUS1.1), J4.B9 (VBUS2.2), S1.9, S1.10, S1.11, S1.12, S1.13, S1.14, S1.15, S1.16, S2.9, S2.10, S2.11, S2.12, S2.13, S2.14, S2.15, S2.16
+3.3VP: C31.2, C68.1, C69.1, IC7.4 (SD), IC7.5 (V+), IC9.35 (~PWDN), IC9.48 (DVDD_1), IC9.50 (DVDD_2), IC9.52 (CLKSEL), IC10.1 (IO1), IC10.3 (GND), J2.A4 (VBUS1.1), J2.A9 (VBUS1.2), J2.B4 (VBUS2.1), J2.B9 (VBUS2.2), J18.20, J18.22, J20.2, J20.4
-2V5: C28.1, C29.1, C32.1, C34.1, C35.1, C36.1, C39.1, C41.1, C70.2, C71.2, C74.1, C75.1, IC8.5 (IO4), IC9.20 (AVSS_1), IC9.23 (AVSS_2), IC9.25 (VREFN), IC9.32 (AVSS_3), IC9.53 (AVSS1), IC9.57 (AVSS_4), IC9.58 (AVSS_5), IC12.5 (IO4), J4.A12 (GND1.2), J4.B1 (GND2.1)
-3V3: C24.1, C25.2, IC7.2 (OUT), IC8.2 (IO2), IC8.3 (GND)
BIAS: IC12.1 (IO1), J4.A9 (VBUS1.2), J4.B4 (VBUS2.1), RN1.1
CLK: J2.B2 (SSTXP2), J18.17, J20.7
CSB1: IC9.39 (~CS), J2.A8 (SBU1), J18.11, J20.13
CSB2: J2.A10 (SSRXN2), J18.13, J20.11
Data: J2.B3 (SSTXN2), J18.19, J20.5
EMG1N: IC8.2 (IO2), J4.A3 (SSTXN1), RN5.2
EMG1NI: CN5.7, IC9.15 (IN1N), RN5.7, S2.2
EMG1P: IC8.1 (IO1), J4.A2 (SSTXP1), RN5.1
EMG1PI: CN5.8, IC9.16 (IN1P), RN5.8, S2.1
EMG2N: IC8.5 (IO4), J4.A6 (DP1), RN5.4
EMG2NI: CN5.5, IC9.13 (IN2N), RN5.5, S2.4
EMG2P: IC8.4 (IO3), J4.A5 (CC1), RN5.3
EMG2PI: CN5.6, IC9.14 (IN2P), RN5.6, S2.3
EMG3N: IC9.2 (IN8P), J4.A8 (SBU1), RN4.2
EMG3NI: CN4.7, IC9.11 (IN3N), RN4.7, S2.6
EMG3P: IC9.1 (IN8N), J4.A7 (DN1), RN4.1
EMG3PI: CN4.8, IC9.12 (IN3P), RN4.8, S2.5
EMG4N: IC9.5 (IN6N), J4.A11 (SSRXP2), RN4.4
EMG4NI: CN4.5, IC9.9 (IN4N), RN4.5, S2.8
EMG4P: IC9.4 (IN7P), J4.A10 (SSRXN2), RN4.3
EMG4PI: CN4.6, IC9.10 (IN4P), RN4.6, S2.7
EMG5N: IC10.2 (IO2), J4.B3 (SSTXN2), RN3.2
EMG5NI: CN3.7, IC9.7 (IN5N), RN3.7, S1.2
EMG5P: IC10.1 (IO1), J4.B2 (SSTXP2), RN3.1
EMG5PI: CN3.8, IC9.8 (IN5P), RN3.8, S1.1
EMG6N: IC10.5 (IO4), J4.B6 (DP2), RN3.4
EMG6NI: CN3.5, IC9.5 (IN6N), RN3.5, S1.4
EMG6P: IC10.4 (IO3), J4.B5 (CC2), RN3.3
EMG6PI: CN3.6, IC9.6 (IN6P), RN3.6, S1.3
EMG7N: IC11.2 (IO2), J4.B8 (SBU2), RN2.2
EMG7NI: CN2.6, IC9.3 (IN7N), RN2.7, S1.6
EMG7P: IC11.1 (IO1), J4.B7 (DN2), RN2.1
EMG7PI: CN2.5, IC9.4 (IN7P), RN2.8, S1.5
EMG8N: IC11.5 (IO4), J4.B11 (SSRXP1), RN2.4
EMG8NI: CN2.8, IC9.1 (IN8N), RN2.5, S1.8
EMG8P: IC11.4 (IO3), J4.B10 (SSRXN1), RN2.3
EMG8PI: CN2.7, IC9.2 (IN8P), RN2.6, S1.7
EMG_BIAS: C30.2, CN1.8, IC9.62 (RLDIN), IC9.63 (RLDOUT), R11.1, RN1.8
EMG_RLDINV: C30.1, IC9.61 (RLDINV), R11.2
EMG_WCT: C29.2, IC9.64 (WCT)
FCLK: J2.A11 (SSRXP2), J18.15, J20.9, TP6.1
GND2: C24.2, C25.1, C26.2, C28.2, C31.1, C36.2, C40.2, C68.2, C69.2, C72.2, C73.2, C74.2, C75.2, CN1.1, CN1.2, CN1.3, CN1.4, CN1.5, CN1.6, CN1.7, CN2.1, CN2.2, CN2.3, CN2.4, CN3.1, CN3.2, CN3.3, CN3.4, CN4.1, CN4.2, CN4.3, CN4.4, CN5.1, CN5.2, CN5.3, CN5.4, IC7.1 (GND), IC8.1 (IO1), IC8.3 (GND), IC9.3 (IN7N), IC9.31 (RESV1), IC9.33 (DGND_1), IC9.49 (DGND_2), IC9.51 (DGND_3), IC9.60 (RLDREF), IC10.2 (IO2), IC10.3 (GND), IC11.3 (GND), IC12.3 (GND), J2.A1 (GND1.1), J2.A12 (GND1.2), J2.B1 (GND2.1), J2.B12 (GND2.2), J2.S1 (SHIELD), J2.S2 (SHIELD), J2.S3 (SHIELD), J2.S4 (SHIELD), J4.A1 (GND1.1), J4.B12 (GND2.2), J4.S1 (SHIELD), J4.S2 (SHIELD), J4.S3 (SHIELD), J4.S4 (SHIELD), J18.21, J18.23, J18.MP1, J18.MP2, J20.1, J20.3, J20.MP1, J20.MP2, RN1.2, RN1.3, RN1.4, RN1.5, RN1.6, RN1.7
INT1: IC9.47 (~DRDY), J2.B5 (CC2), J18.2, J20.22, TP7.1
INT2: J2.B6 (DP2), J18.4, J20.20
INT3: J2.B7 (DN2), J18.6, J20.18
INT4: J2.B8 (SBU2), J18.8, J20.16
unnamed: C23.1, IC7.3 (CAP-)
unnamed: C23.2, IC7.6 (CAP+)
unnamed: C26.1, IC8.4 (IO3)
unnamed: C32.2, IC9.24 (VREFP)
unnamed: C34.2, IC9.26 (VCAP4)
unnamed: C35.2, IC9.28 (VCAP1)
unnamed: C39.2, IC9.30 (VCAP2)
unnamed: C41.2, IC9.55 (VCAP3)
Reset: IC9.36 (~RESET), J2.B11 (SSRXP1), J18.12, J20.12, TP1.1
SCL: J2.A2 (SSTXP1), J18.1, J20.23
SCLK: IC9.40 (SCLK), J2.A5 (CC1), J18.5, J20.19, TP3.1
SDA: J2.A3 (SSTXN1), J18.3, J20.21
SDI: IC9.34 (DIN), J2.A6 (DP1), J18.7, J20.17, TP4.1
SDO: IC9.43 (DOUT), J2.A7 (DN1), J18.9, J20.15, TP5.1
Start: IC9.38 (START), J2.B10 (SSRXN1), J18.10, J20.14, TP1.1

Notes on the sheet:
Buttom Connectors
Note4
Note2
ADS Decoupling
Note1: TVS Diodes Quad CH Hi Spd ESD Protect Device
Note4: SPST (normaly open) dip switches. Unused pins should be switched on.
Note1
Note3
Interface Test Points
USB-C Receptacle
Electrodes Filters and Protections
Power Supply
Top Connectors
EMG/ECG/EEG Electrodes
Note3: Capacitor Arrays & Networks 0805 50V 1000pF X7R 20% 4-N-1
Electrocardiography & Electromyography & Electroencephalography ADS1298
Mounting Holes
Channels selection Dip Switches
CIN and COUT: 3.3uF, Max ESR 0.3ohm.
EMG & ECG & EEG Module, Biopotential (EMG, ECG and EEG) Measurements
FFC Connectors
Notes
Note2: Resistor Networks & Arrays 2.2K 1% Convex 4 resistors
