esl-epfl/VersaSens/VersaSens_HW/Main.kicad_sch

## KiCad design VersaSens_HW/Main.kicad_sch (2024-08-30)

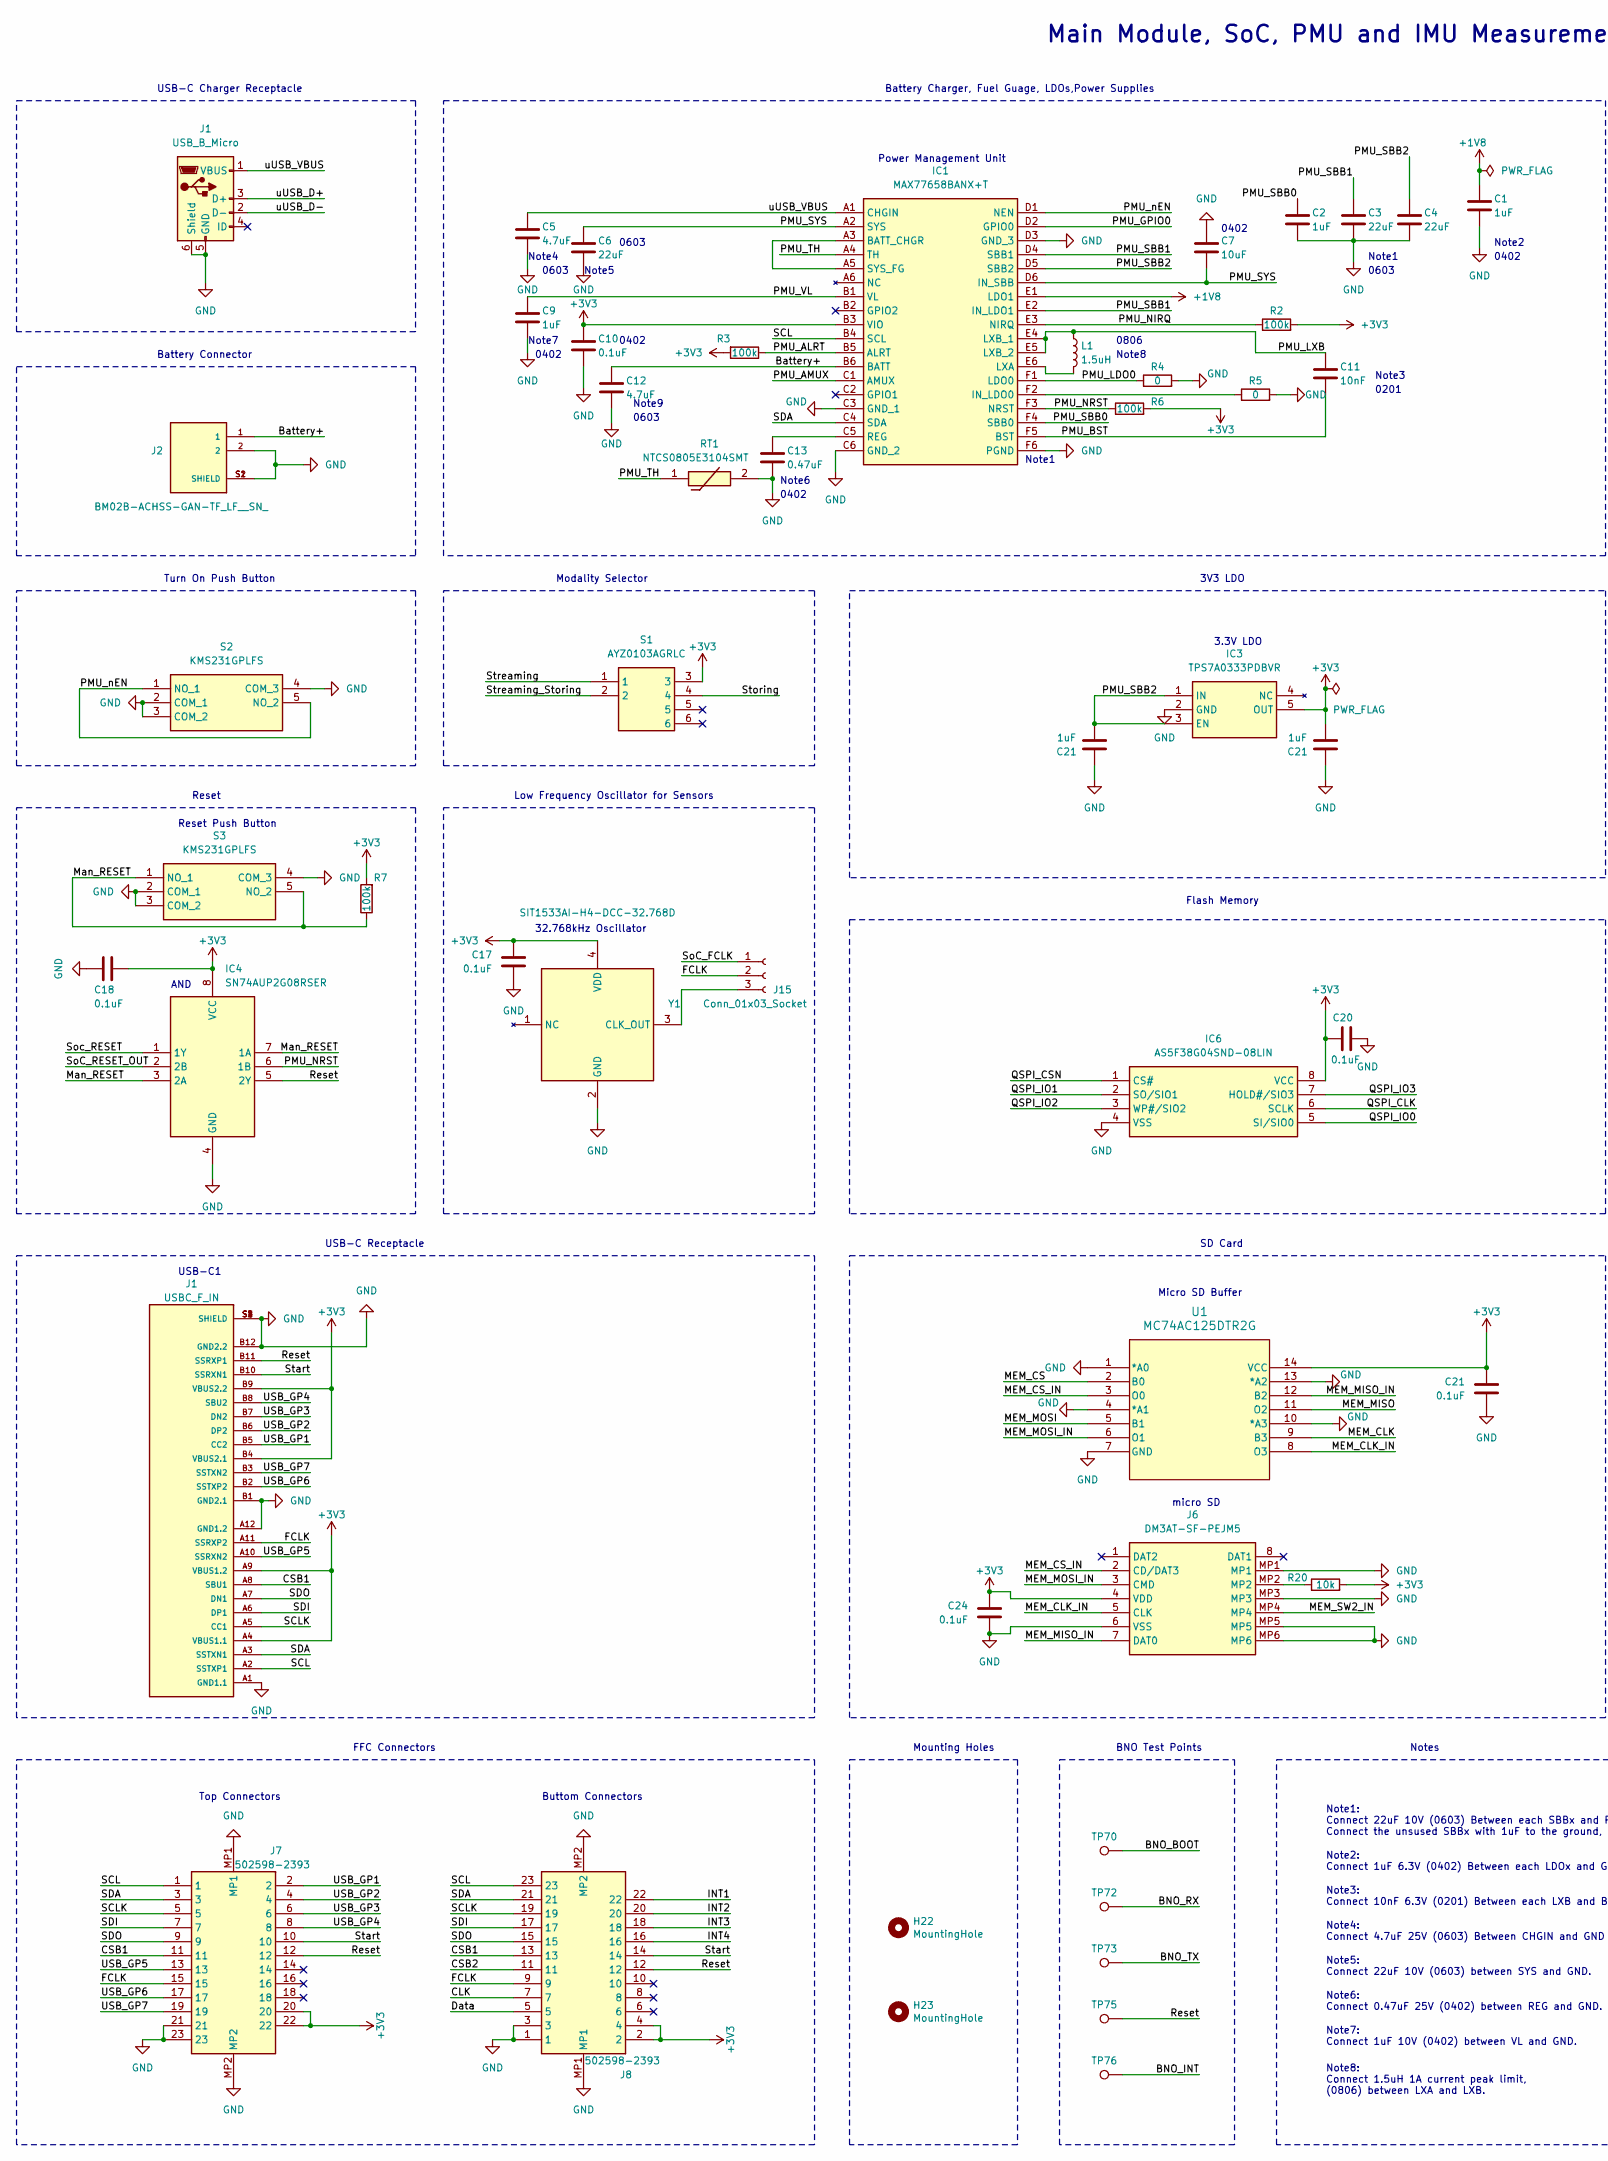
[picture p17: schematic Main.kicad_sch, part in row 1, column 1]

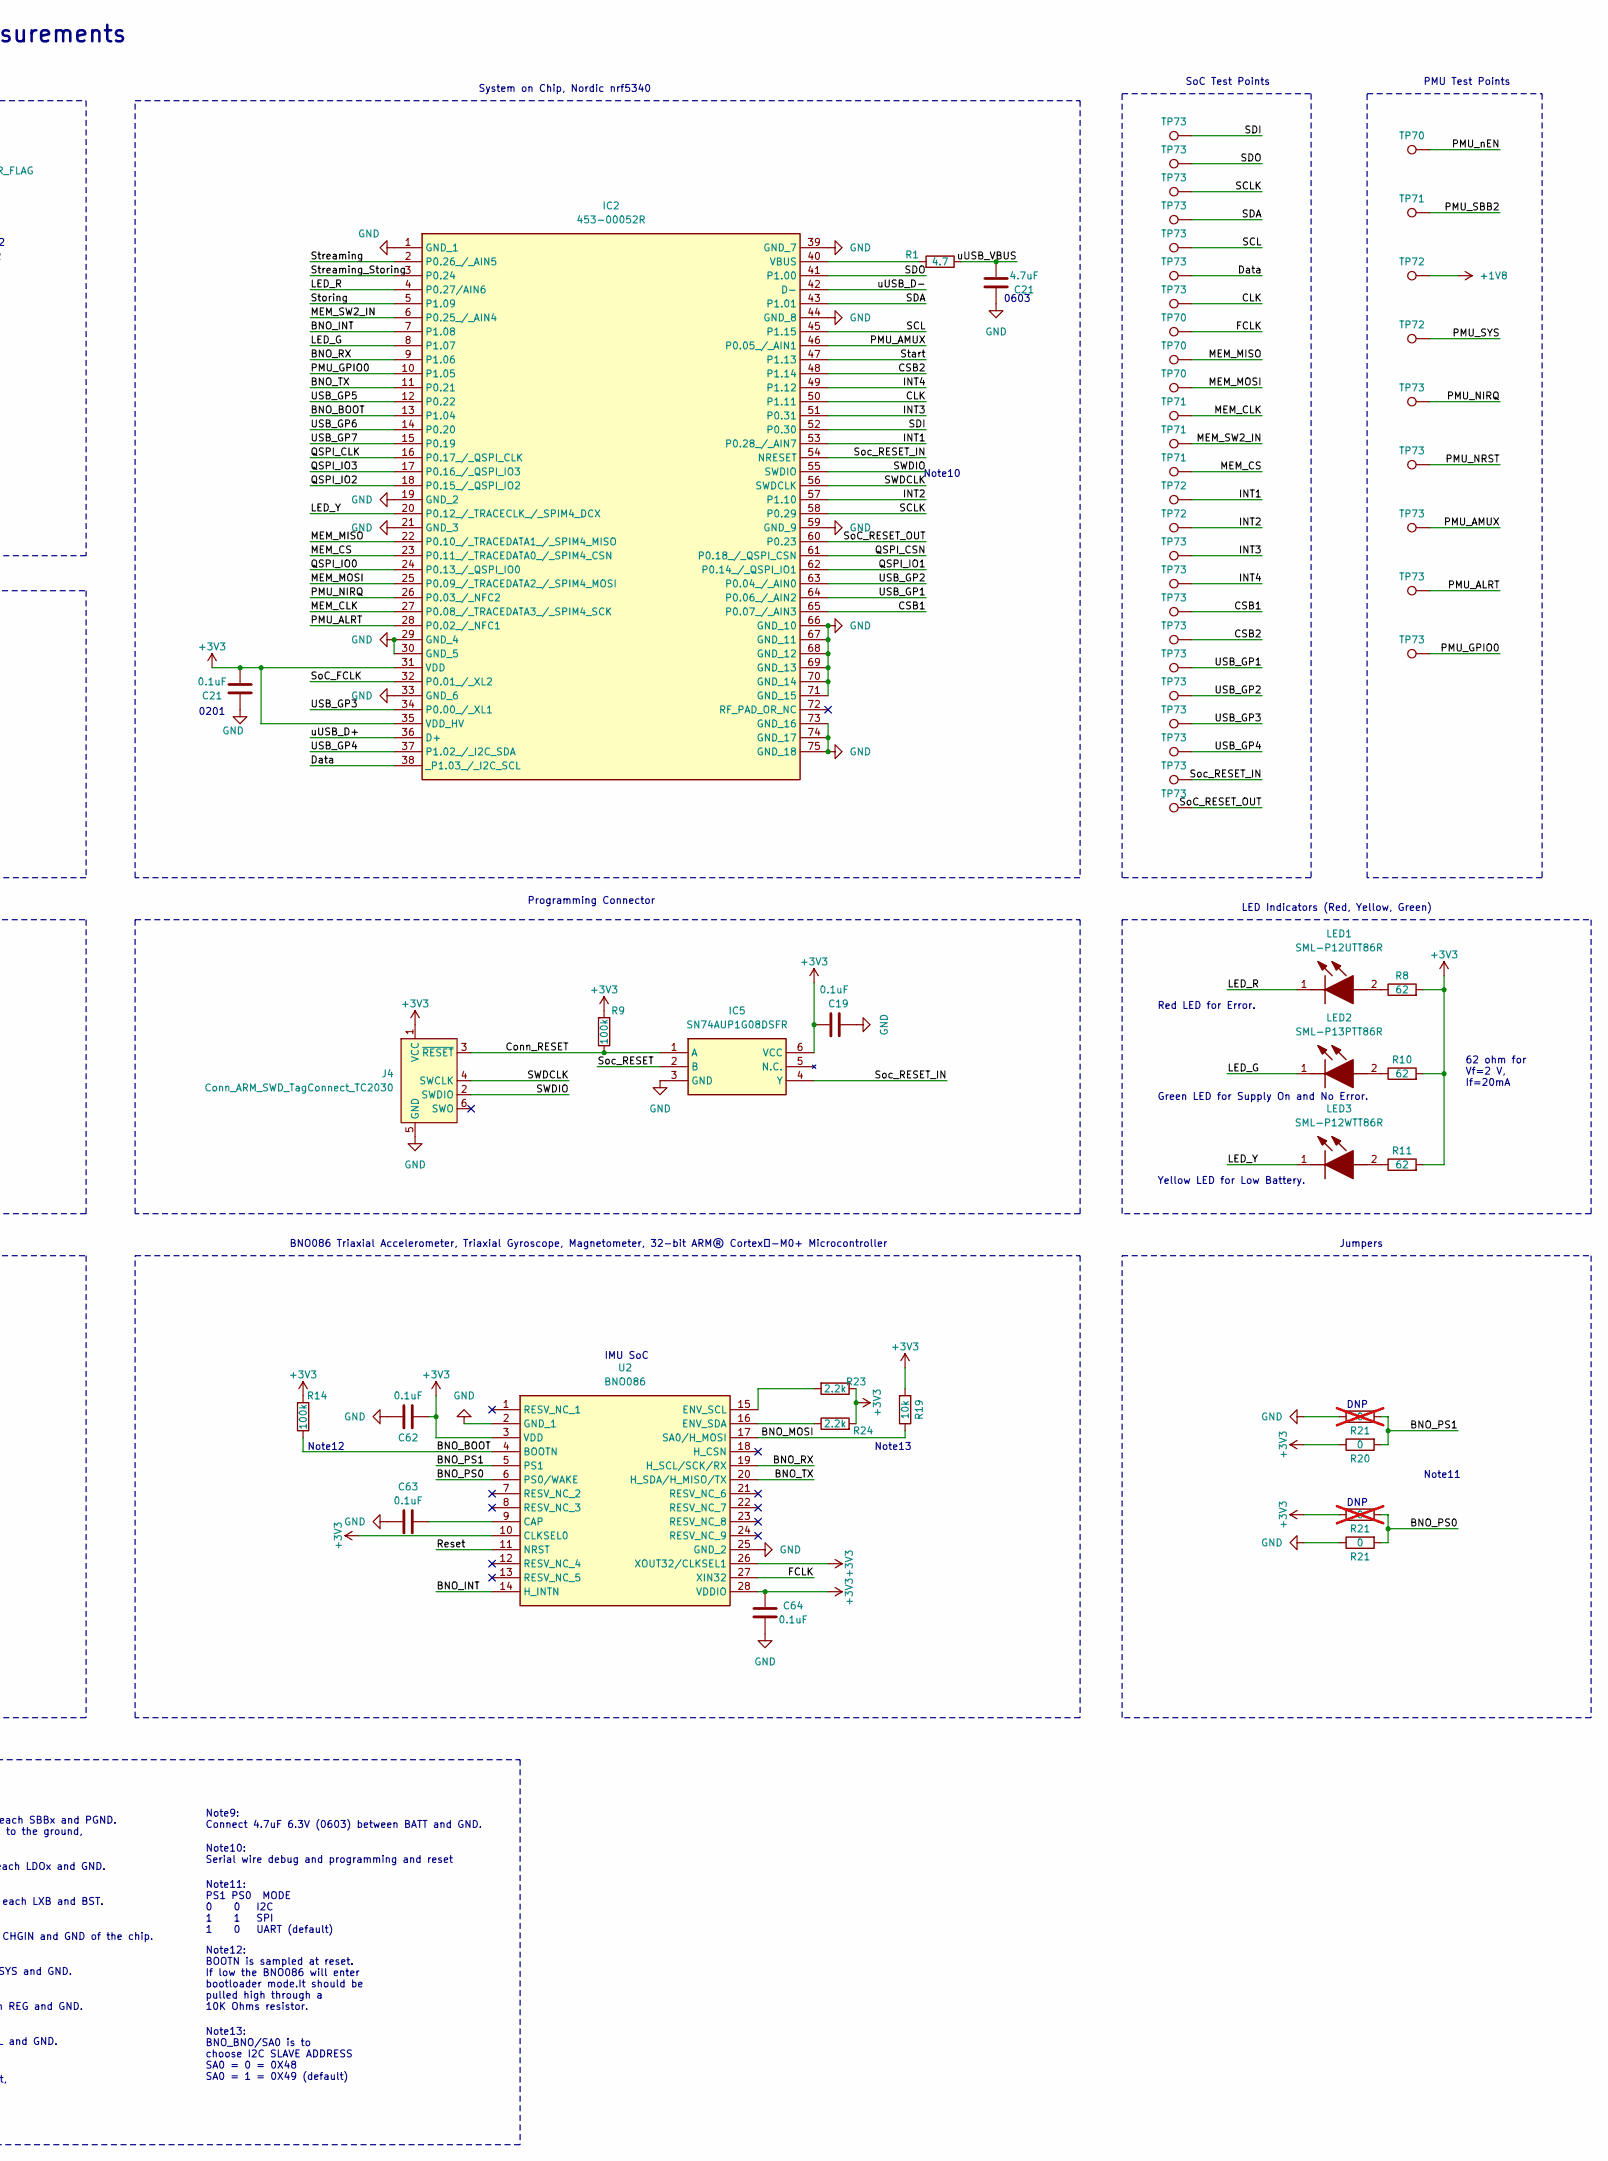
[picture p18: schematic Main.kicad_sch, part in row 1, column 2]

Parts:
C1, C2, C9, C21: 1uF; C_0402_1005Metric
C3, C4, C6: 22uF; C_0603_1608Metric
C5, C12: 4.7uF; C_0603_1608Metric
C7: 10uF; C_0402_1005Metric
C10, C17, C18, C19, C20, C24, C62, C63, C64: 0.1uF; C_0402_1005Metric
C11: 10nF; C_0201_0603Metric
C13: 0.47uF; C_0402_1005Metric
H22, H23: MountingHole; MountingHole_2.5mm
IC1: MAX77658BANX+T; BGA36C50P6X6_323X296X50; Manufacturer_Part_Number MAX77658BANX+T
IC2: 453-00052R; 45300052R; Mouser Part Number 239-453-00052R
IC3: TPS7A0333PDBVR; SOT95P280X145-5N; Mouser Part Number 595-TPS7A0333PDBVR
IC4: SN74AUP2G08RSER; RSE0008A; Mouser Part Number 595-SN74AUP2G08RSER
IC5: SN74AUP1G08DSFR; SON35P100X100X40-6N; Mouser Part Number 595-SN74AUP1G08DSFR
IC6: AS5F38G04SND-08LIN; SON127P800X600X80-8N; Mouser Part Number 913-S5F38G04SND08LIN
J1: USBC_F_IN; GCT_USB4055-30-A; PARTREV B; DIGI-KEY_PART_NUMBER 2073-USB4055-30-ACT-ND
J2: BM02B-ACHSS-GAN-TF_LF__SN_; JST_BM02B-ACHSS-GAN-TF_LF__SN_
J4: Conn_ARM_SWD_TagConnect_TC2030; Tag-Connect_TC2030-IDC-NL_2x03_P1.27mm_Vertical
J6: DM3AT-SF-PEJM5; DM3ATSFPEJM5; Mouser Part Number 798-DM3AT-SF-PEJM5
J7, J8: 502598-2393; 5025982393; Mouser Part Number 538-502598-2393
J15: Conn_01x03_Socket; HDRV3W40P0X127_1X3_381X210X430P
L1: 1.5uH; 1285ASH1R0MP2
LED1: SML-P12UTT86R; LEDC1006X25N; Mouser Part Number 755-SML-P12UTT86R
LED2: SML-P13PTT86R; LEDC1006X25N; Mouser Part Number 755-SML-P13PTT86R
LED3: SML-P12WTT86R; LEDC1006X25N; Mouser Part Number 755-SML-P12WTT86R
R1: 4.7; R_0402_1005Metric
R2, R3, R6, R7, R9, R14: 100k; R_0402_1005Metric
R4, R5, R21: 0; R_0402_1005Metric
R8, R10, R11: 62; R_0402_1005Metric
R19, R20: 10k; R_0402_1005Metric
R23, R24: 2.2k; R_0402_1005Metric
RT1: NTCS0805E3104SMT; THRMC2012X95N; Mouser Part Number 594-NTCS0805E3104SMT
S1: AYZ0103AGRLC; Mouser Part Number 611-AYZ0103AGRLC
S2, S3: KMS231GPLFS; Mouser Part Number 611-KMS231GPLFS
TP70, TP71, TP72, TP73, TP75, TP76: TestPoint; TestPoint_Pad_D1.0mm
U1: MC74AC125DTR2G; TSSOP14_4P50X5P10_ONS
U2: BNO086; Mouser Part Number 526-BNO086
Y1: SIT1533AI-H4-DCC-32.768D; SIT1534AIH4DCC00032G; Mouser Part Number 788-1533AIH4DCC32.7D

Connections:
+1V8: C1.1, IC1.E1 (LDO1), TP72.1
+3V3: C10.1, C17.1, C18.1, C19.1, C20.1, C21.1, C21.2, C24.1, C62.1, C64.1, IC1.B3 (VIO), IC2.31 (VDD), IC2.35 (VDD_HV), IC3.5 (OUT), IC4.8 (VCC), IC5.6 (VCC), IC6.8 (VCC), J1.A4 (VBUS1.1), J1.A9 (VBUS1.2), J1.B4 (VBUS2.1), J1.B9 (VBUS2.2), J4.1 (VCC), J6.4 (VDD), J7.20, J7.22, J8.2, J8.4, R2.2, R3.2, R6.2, R7.2, R8.2, R9.2, R10.2, R11.2, R14.2, R19.2, R20.1, R20.2, R21.1, R23.1, R24.2, S1.3, U1.14 (VCC), U2.3 (VDD), U2.10 (CLKSEL0), U2.26 (XOUT32/CLKSEL1), U2.28 (VDDIO), Y1.4 (VDD)
BNO_BOOT: IC2.13 (P1.04), R14.1, TP70.1, U2.4 (BOOTN)
BNO_INT: IC2.7 (P1.08), TP76.1, U2.14 (H_INTN)
BNO_MOSI: R19.1, U2.17 (SA0/H_MOSI)
BNO_PS0: R21.2, U2.6 (PS0/WAKE)
BNO_PS1: R20.2, R21.2, U2.5 (PS1)
BNO_RX: IC2.9 (P1.06), TP72.1, U2.19 (H_SCL/SCK/RX)
BNO_TX: IC2.11 (P0.21), TP73.1, U2.20 (H_SDA/H_MISO/TX)
Battery+: C12.1, IC1.B6 (BATT), J2.1
CLK: IC2.50 (P1.11), J8.7, TP73.1
CSB1: IC2.65 (P0.07_/_AIN3), J1.A8 (SBU1), J7.11, J8.13, TP73.1
CSB2: IC2.48 (P1.14), J8.11, TP73.1
Conn_RESET: IC5.1 (A), J4.3 (~RESET), R9.1
Data: IC2.38 (_P1.03_/_I2C_SCL), J8.5, TP73.1
FCLK: J1.A11 (SSRXP2), J7.15, J8.9, J15.2, TP70.1, U2.27 (XIN32)
GND: C1.2, C2.2, C3.2, C4.2, C5.2, C6.2, C7.1, C9.2, C10.2, C12.2, C13.2, C17.2, C18.2, C19.2, C20.2, C21.1, C21.2, C24.2, C62.2, C63.1, C64.2, IC1.C3 (GND_1), IC1.C6 (GND_2), IC1.D3 (GND_3), IC1.F6 (PGND), IC2.1 (GND_1), IC2.19 (GND_2), IC2.21 (GND_3), IC2.29 (GND_4), IC2.30 (GND_5), IC2.33 (GND_6), IC2.39 (GND_7), IC2.44 (GND_8), IC2.59 (GND_9), IC2.66 (GND_10), IC2.67 (GND_11), IC2.68 (GND_12), IC2.69 (GND_13), IC2.70 (GND_14), IC2.71 (GND_15), IC2.73 (GND_16), IC2.74 (GND_17), IC2.75 (GND_18), IC3.2 (GND), IC4.4 (GND), IC5.3 (GND), IC6.4 (VSS), J1.5 (GND), J1.6 (Shield), J1.A1 (GND1.1), J1.A12 (GND1.2), J1.B1 (GND2.1), J1.B12 (GND2.2), J1.S1 (SHIELD), J1.S2 (SHIELD), J1.S3 (SHIELD), J1.S4 (SHIELD), J2.2, J2.S1 (SHIELD), J2.S2 (SHIELD), J4.5 (GND), J6.6 (VSS), J6.MP1, J6.MP3, J6.MP5, J6.MP6, J7.21, J7.23, J7.MP1, J7.MP2, J8.1, J8.3, J8.MP1, J8.MP2, R4.2, R5.2, R21.1, RT1.2, S2.2 (COM_1), S2.3 (COM_2), S2.4 (COM_3), S3.2 (COM_1), S3.3 (COM_2), S3.4 (COM_3), U1.1 (*A0), U1.4 (*A1), U1.7 (GND), U1.10 (*A3), U1.13 (*A2), U2.2 (GND_1), U2.25 (GND_2), Y1.2 (GND)
INT1: IC2.53 (P0.28_/_AIN7), J8.22, TP72.1
INT2: IC2.57 (P1.10), J8.20, TP72.1
INT3: IC2.51 (P0.31), J8.18, TP73.1
INT4: IC2.49 (P1.12), J8.16, TP73.1
LED_G: IC2.8 (P1.07), LED2.1 (K)
LED_R: IC2.4 (P0.27/AIN6), LED1.1 (K)
LED_Y: IC2.20 (P0.12_/_TRACECLK_/_SPIM4_DCX), LED3.1 (K)
MEM_CLK: IC2.27 (P0.08_/_TRACEDATA3_/_SPIM4_SCK), TP71.1, U1.9 (B3)
MEM_CLK_IN: J6.5 (CLK), U1.8 (O3)
MEM_CS: IC2.23 (P0.11_/_TRACEDATA0_/_SPIM4_CSN), TP71.1, U1.2 (B0)
MEM_CS_IN: J6.2 (CD/DAT3), U1.3 (O0)
MEM_MISO: IC2.22 (P0.10_/_TRACEDATA1_/_SPIM4_MISO), TP70.1, U1.11 (O2)
MEM_MISO_IN: J6.7 (DAT0), U1.12 (B2)
MEM_MOSI: IC2.25 (P0.09_/_TRACEDATA2_/_SPIM4_MOSI), TP70.1, U1.5 (B1)
MEM_MOSI_IN: J6.3 (CMD), U1.6 (O1)
MEM_SW2_IN: IC2.6 (P0.25_/_AIN4), J6.MP4, TP71.1
Man_RESET: IC4.3 (2A), IC4.7 (1A), R7.1, S3.1 (NO_1), S3.5 (NO_2)
unnamed: C13.1, IC1.C5 (REG)
unnamed: C63.2, U2.9 (CAP)
unnamed: IC1.A3 (BATT_CHGR), IC1.A5 (SYS_FG)
unnamed: IC1.E6 (LXA), L1.2
unnamed: IC1.F2 (IN_LDO0), R5.1
unnamed: IC2.40 (VBUS), R1.2
unnamed: J6.MP2, R20.1
unnamed: J15.3, Y1.3 (CLK_OUT)
unnamed: LED1.2 (A), R8.1
unnamed: LED2.2 (A), R10.1
unnamed: LED3.2 (A), R11.1
unnamed: R23.2, U2.15 (ENV_SCL)
unnamed: R24.1, U2.16 (ENV_SDA)
PMU_ALRT: IC1.B5 (ALRT), IC2.28 (P0.02_/_NFC1), R3.1, TP73.1
PMU_AMUX: IC1.C1 (AMUX), IC2.46 (P0.05_/_AIN1), TP73.1
PMU_BST: C11.2, IC1.F5 (BST)
PMU_GPIO0: IC1.D2 (GPIO0), IC2.10 (P1.05), TP73.1
PMU_LDO0: IC1.F1 (LDO0), R4.1
PMU_LXB: C11.1, IC1.E4 (LXB_1), IC1.E5 (LXB_2), L1.1
PMU_NIRQ: IC1.E3 (NIRQ), IC2.26 (P0.03_/_NFC2), R2.1, TP73.1
PMU_NRST: IC1.F3 (NRST), IC4.6 (1B), R6.1, TP73.1
PMU_SBB0: C2.1, IC1.F4 (SBB0)
PMU_SBB1: C3.1, IC1.D4 (SBB1), IC1.E2 (IN_LDO1)
PMU_SBB2: C4.1, C21.2, IC1.D5 (SBB2), IC3.1 (IN), IC3.3 (EN), TP71.1
PMU_SYS: C6.1, C7.2, IC1.A2 (SYS), IC1.D6 (IN_SBB), TP72.1
PMU_TH: IC1.A4 (TH), RT1.1
PMU_VL: C9.1, IC1.B1 (VL)
PMU_nEN: IC1.D1 (NEN), S2.1 (NO_1), S2.5 (NO_2), TP70.1
QSPI_CLK: IC2.16 (P0.17_/_QSPI_CLK), IC6.6 (SCLK)
QSPI_CSN: IC2.61 (P0.18_/_QSPI_CSN), IC6.1 (CS#)
QSPI_IO0: IC2.24 (P0.13_/_QSPI_IO0), IC6.5 (SI/SIO0)
QSPI_IO1: IC2.62 (P0.14_/_QSPI_IO1), IC6.2 (SO/SIO1)
QSPI_IO2: IC2.18 (P0.15_/_QSPI_IO2), IC6.3 (WP#/SIO2)
QSPI_IO3: IC2.17 (P0.16_/_QSPI_IO3), IC6.7 (HOLD#/SIO3)
Reset: IC4.5 (2Y), J1.B11 (SSRXP1), J7.12, J8.12, TP75.1, U2.11 (NRST)
SCL: IC1.B4 (SCL), IC2.45 (P1.15), J1.A2 (SSTXP1), J7.1, J8.23, TP73.1
SCLK: IC2.58 (P0.29), J1.A5 (CC1), J7.5, J8.19, TP73.1
SDA: IC1.C4 (SDA), IC2.43 (P1.01), J1.A3 (SSTXN1), J7.3, J8.21, TP73.1
SDI: IC2.52 (P0.30), J1.A6 (DP1), J7.7, J8.17, TP73.1
SDO: IC2.41 (P1.00), J1.A7 (DN1), J7.9, J8.15, TP73.1
SWDCLK: IC2.56 (SWDCLK), J4.4 (SWCLK)
SWDIO: IC2.55 (SWDIO), J4.2 (SWDIO)
SoC_FCLK: IC2.32 (P0.01_/_XL2), J15.1
SoC_RESET_OUT: IC2.60 (P0.23), IC4.2 (2B), TP73.1
Soc_RESET: IC4.1 (1Y), IC5.2 (B)
Soc_RESET_IN: IC2.54 (NRESET), IC5.4 (Y), TP73.1
Start: IC2.47 (P1.13), J1.B10 (SSRXN1), J7.10, J8.14
Storing: IC2.5 (P1.09), S1.4
Streaming: IC2.2 (P0.26_/_AIN5), S1.1
Streaming_Storing: IC2.3 (P0.24), S1.2
USB_GP1: IC2.64 (P0.06_/_AIN2), J1.B5 (CC2), J7.2, TP73.1
USB_GP2: IC2.63 (P0.04_/_AIN0), J1.B6 (DP2), J7.4, TP73.1
USB_GP3: IC2.34 (P0.00_/_XL1), J1.B7 (DN2), J7.6, TP73.1
USB_GP4: IC2.37 (P1.02_/_I2C_SDA), J1.B8 (SBU2), J7.8, TP73.1
USB_GP5: IC2.12 (P0.22), J1.A10 (SSRXN2), J7.13
USB_GP6: IC2.14 (P0.20), J1.B2 (SSTXP2), J7.17
USB_GP7: IC2.15 (P0.19), J1.B3 (SSTXN2), J7.19
uUSB_D+: IC2.36 (D+), J1.3 (D+)
uUSB_D-: IC2.42 (D-), J1.2 (D-)
uUSB_VBUS: C5.1, C21.2, IC1.A1 (CHGIN), J1.1 (VBUS), R1.1

Notes on the sheet:
0402
Note4
Green LED for Supply On and No Error.
Power Management Unit
LED Indicators (Red, Yellow, Green)
Note1: Connect 22uF 10V (0603) Between each SBBx and PGND. Connect the unsused SBBx with 1uF to the ground,
FFC Connectors
BNO086 Triaxial Accelerometer, Triaxial Gyroscope, Magnetometer, 32-bit ARM® Cortex™-M0+ Microcontroller
Note8
Note12: BOOTN is sampled at reset. If low the BNO086 will enter bootloader mode.It should be pulled high through a 10K Ohms resistor.
Reset
0603
32.768kHz Oscillator
Note11
Buttom Connectors
Note7
Note5
Programming Connector
Note6: Connect 0.47uF 25V (0402) between REG and GND.
USB-C Charger Receptacle
IMU SoC
USB-C1
BNO Test Points
Note1
0806
Yellow LED for Low Battery.
Flash Memory
Note13: BNO_BNO/SA0 is to choose I2C SLAVE ADDRESS SA0 = 0 = 0X48 SA0 = 1 = 0X49 (default)
SoC Test Points
Note6
Mounting Holes
Note10: Serial wire debug and programming and reset
Note12
Note2: Connect 1uF 6.3V (0402) Between each LDOx and GND.
Turn On Push Button
Low Frequency Oscillator for Sensors
Micro SD Buffer
Notes
System on Chip, Nordic nrf5340
AND
DNP
0201
Reset Push Button
Note3: Connect 10nF 6.3V (0201) Between each LXB and BST.
Modality Selector
PMU Test Points
62 ohm for Vf=2 V, If=20mA
3.3V LDO
Note9: Connect 4.7uF 6.3V (0603) between BATT and GND.
USB-C Receptacle
Note2
Top Connectors
micro SD
Note5: Connect 22uF 10V (0603) between SYS and GND.
Battery Charger, Fuel Guage, LDOs,Power Supplies
Battery Connector
SD Card
Note10
Note13
3V3 LDO
Note4: Connect 4.7uF 25V (0603) Between CHGIN and GND of the chip.
Note7: Connect 1uF 10V (0402) between VL and GND.
Note9
Main Module, SoC, PMU and IMU Measurements
Note11: PS1 PS0 MODE 0 0 I2C 1 1 SPI 1 0 UART (default)
Note8: Connect 1.5uH 1A current peak limit, (0806) between LXA and LXB.
Note3
Jumpers
Red LED for Error.
