esl-epfl/VersaSens/VersaSens_HW/PPG.kicad_sch

## KiCad design VersaSens_HW/PPG.kicad_sch (2024-08-30)

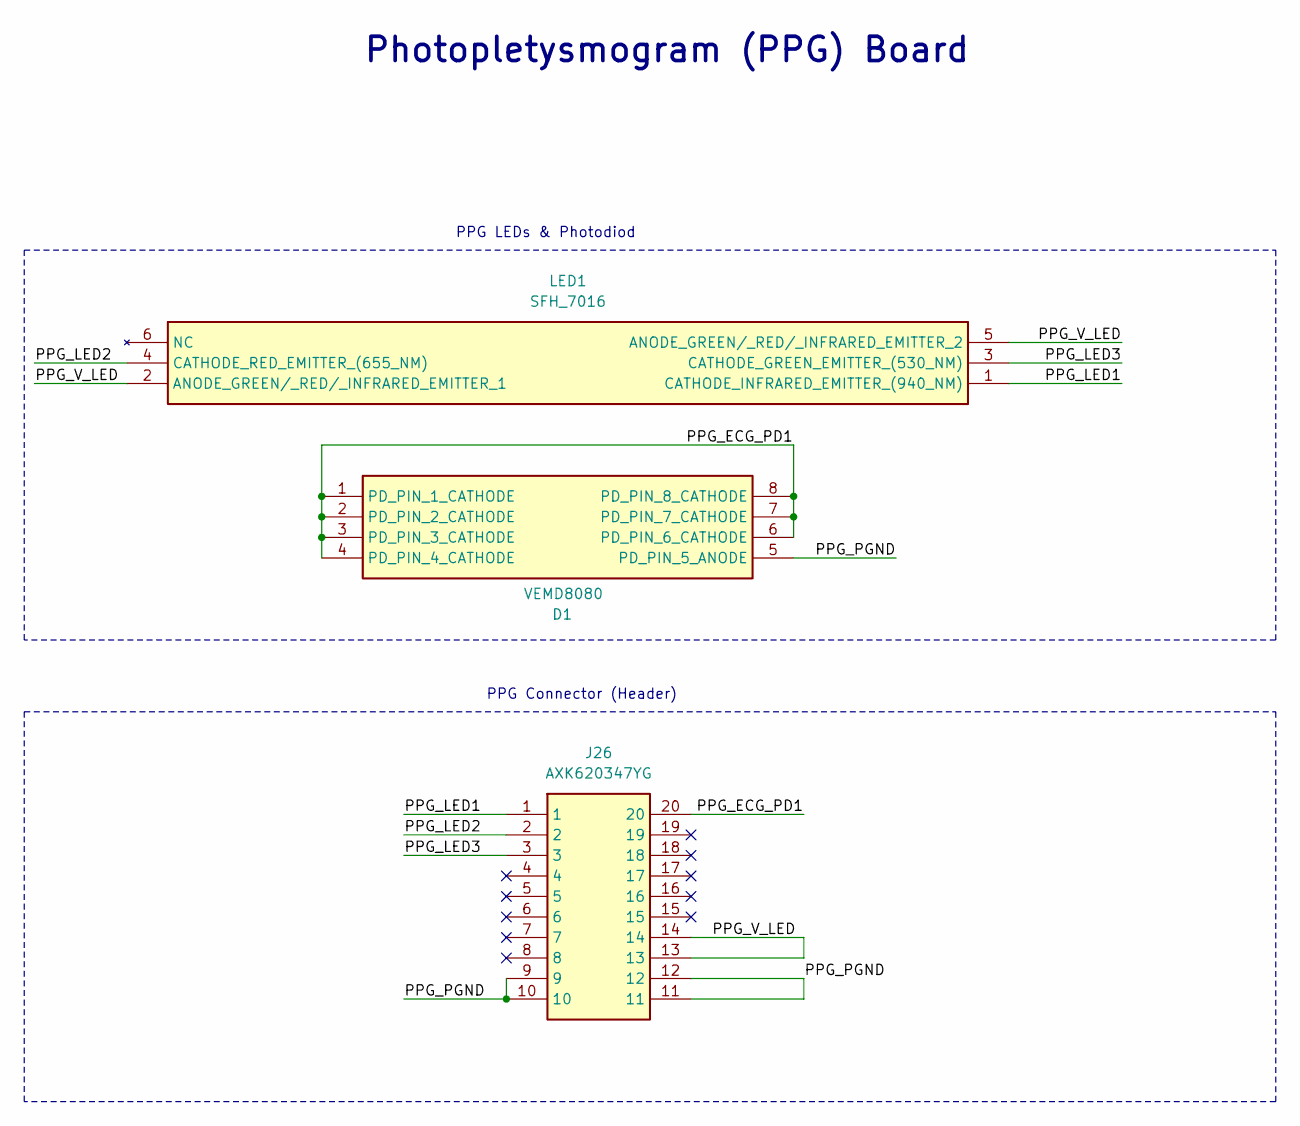
[picture p19: schematic PPG.kicad_sch]

Parts:
D1: VEMD8080; Manufacturer_Part_Number VEMD8080; Mouser Part Number 78-VEMD8080
J26: AXK620347YG; Mouser Part Number 769-AXK620347YG
LED1: SFH_7016; SFH7016; Manufacturer_Part_Number SFH 7016; Mouser Part Number 720-SFH7016

Connections:
PPG_ECG_PD1: D1.1 (PD_PIN_1_CATHODE), D1.2 (PD_PIN_2_CATHODE), D1.3 (PD_PIN_3_CATHODE), D1.4 (PD_PIN_4_CATHODE), D1.6 (PD_PIN_6_CATHODE), D1.7 (PD_PIN_7_CATHODE), D1.8 (PD_PIN_8_CATHODE), J26.20
PPG_LED1: J26.1, LED1.1 (CATHODE_INFRARED_EMITTER_(940_NM))
PPG_LED2: J26.2, LED1.4 (CATHODE_RED_EMITTER_(655_NM))
PPG_LED3: J26.3, LED1.3 (CATHODE_GREEN_EMITTER_(530_NM))
PPG_PGND: D1.5 (PD_PIN_5_ANODE), J26.9, J26.10, J26.11, J26.12
PPG_V_LED: J26.13, J26.14, LED1.2 (ANODE_GREEN/_RED/_INFRARED_EMITTER_1), LED1.5 (ANODE_GREEN/_RED/_INFRARED_EMITTER_2)

Notes on the sheet:
PPG Connector (Header)
Photopletysmogram (PPG) Board
PPG LEDs & Photodiod
