esl-epfl/VersaSens/VersaSens_HW/VersaHeepo.kicad_sch

## KiCad design VersaSens_HW/VersaHeepo.kicad_sch (2024-08-30)

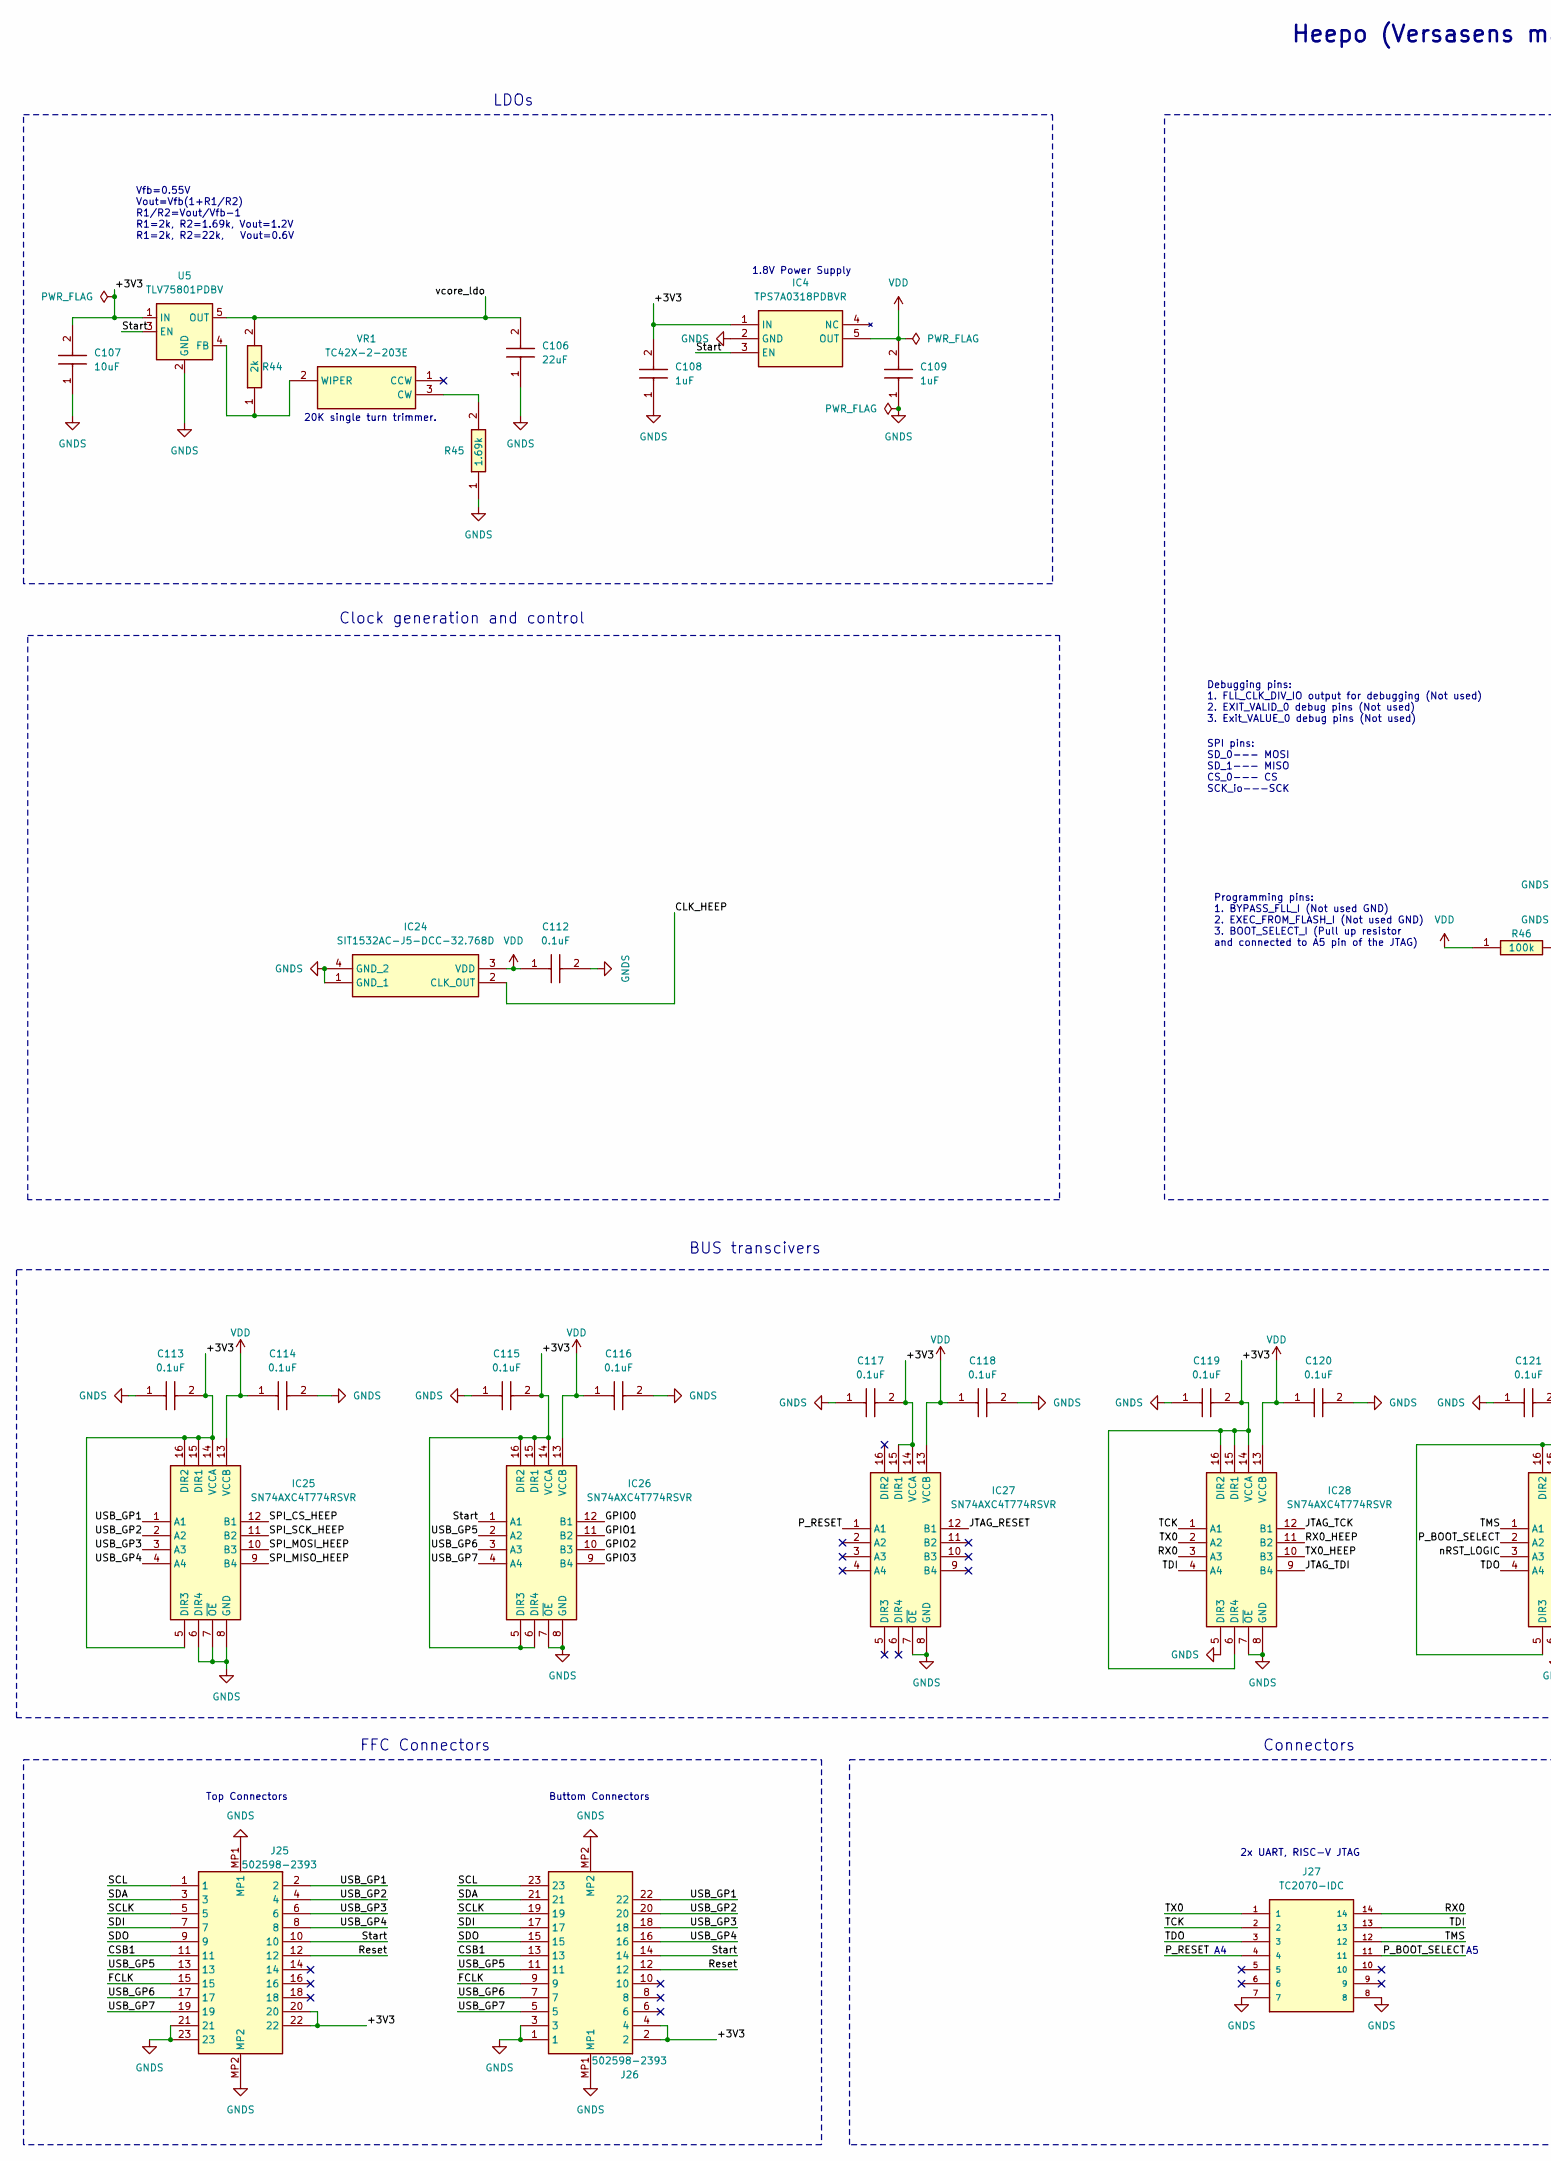
[picture p20: schematic VersaHeepo.kicad_sch, part in row 1, column 1]

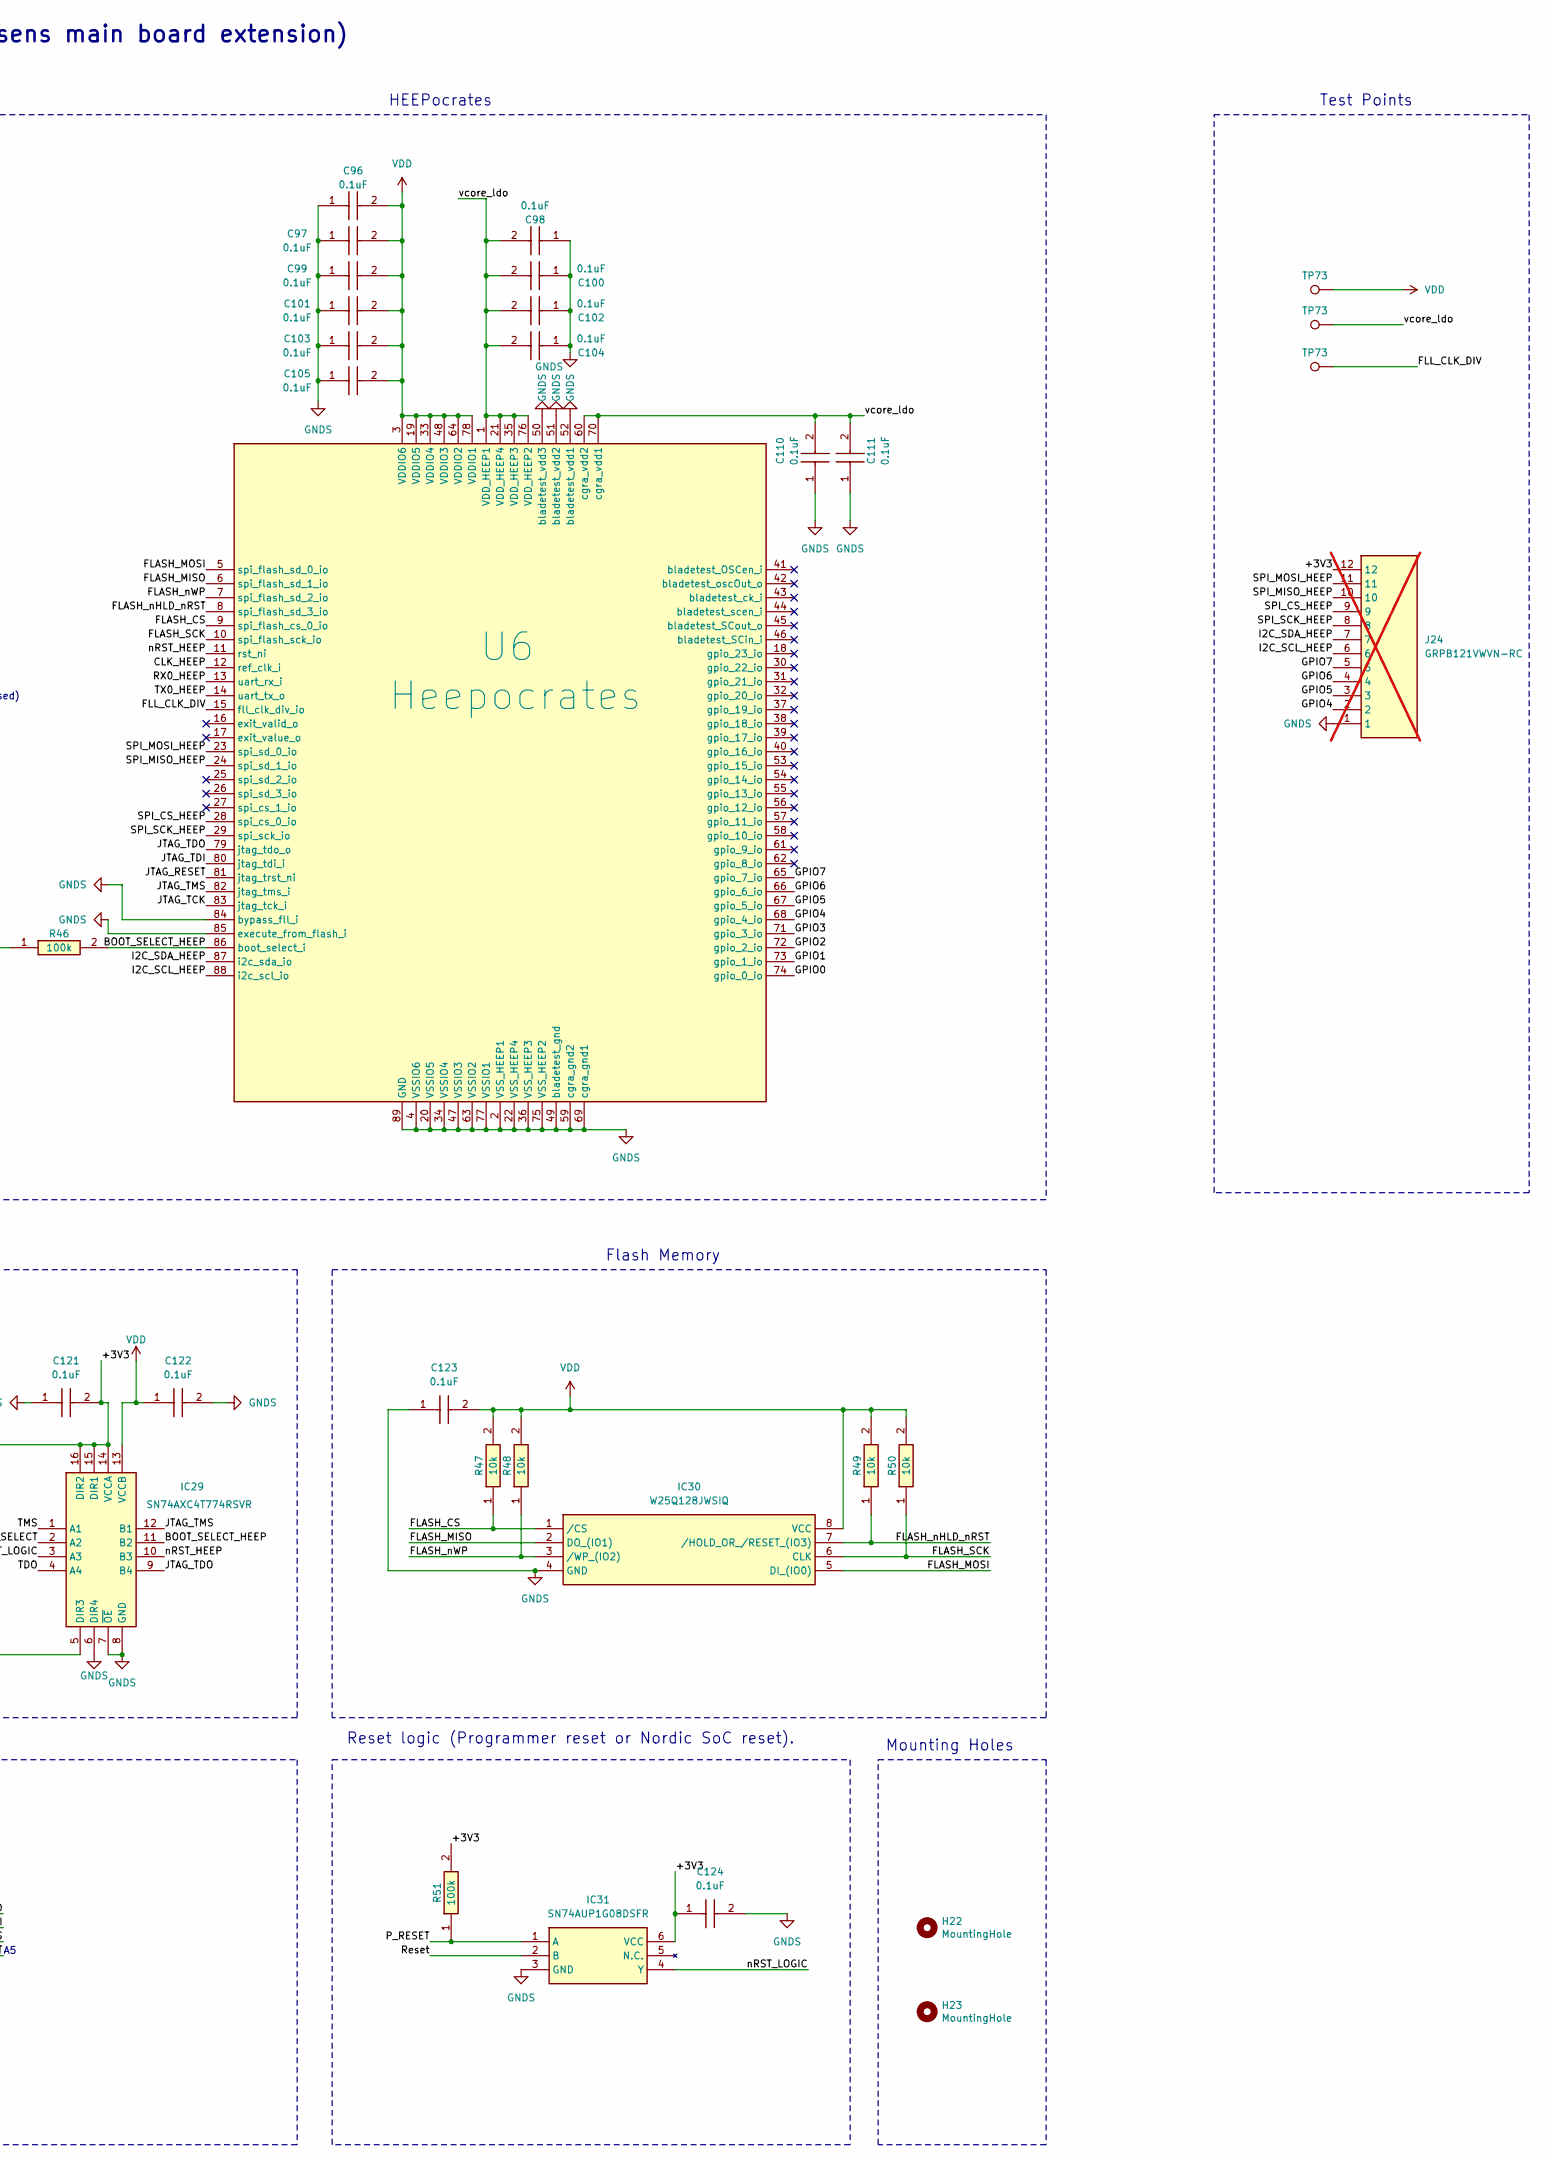
[picture p21: schematic VersaHeepo.kicad_sch, part in row 1, column 2]

Parts:
C96, C97, C98, C99, C100, C101, C102, C103, C104, C105, C110, C111, C112, C113, C114, C115, C116, C117, C118, C119, C120, C121, C122, C123, C124: 0.1uF; C0402C104J4RACTU; Mouser Part Number 80-C0402C104K9P
C106: 22uF; CAPC1608X80N; Mouser Part Number 81-GRM187R61A226ME5D
C107: 10uF; CAPC1005X70N; Manufacturer_Part_Number GRT155R60J106ME13D
C108, C109: 1uF; CAPC1005X55N; Mouser Part Number 81-GRM155R70J105KA2J
H22, H23: MountingHole; MountingHole_2.5mm
IC4: TPS7A0318PDBVR; SOT95P280X145-5N; Mouser Part Number 595-TPS7A0318PDBVR
IC24: SIT1532AC-J5-DCC-32.768D; SIT1532ACJ5DCC32768D; Mouser Part Number 788-1532ACJ5DCC32.7D
IC25, IC26, IC27, IC28, IC29: SN74AXC4T774RSVR; QFN40P180X260X55-16N; Mouser Part Number 595-SN74AXC4T774RSVR
IC30: W25Q128JWSIQ; SOIC127P790X216-8N; Mouser Part Number 454-W25Q128JWSIQ
IC31: SN74AUP1G08DSFR; SON35P100X100X40-6N; Mouser Part Number 595-SN74AUP1G08DSFR
J24: GRPB121VWVN-RC; GRPB121VWVNRC; Manufacturer_Part_Number GRPB121VWVN-RC; not fitted
J25, J26: 502598-2393; 5025982393; Mouser Part Number 538-502598-2393
J27: TC2070-IDC; TC2070-NL-FP; PARTREV C
R44: 2k; RESC1005X37N; Mouser Part Number 652-CR0402AFX2001GLF
R45: 1.69k; RESC1005X40N; Manufacturer_Part_Number CR0402-FX-1691GLF
R46, R51: 100k; RESC1005X37N; Mouser Part Number 603-AC0402FR-7W100KL
R47, R48, R49, R50: 10k; RESC1005X40N; Mouser Part Number 652-CR0402FX-1002GLF
TP73: TestPoint; TestPoint_Pad_D1.0mm
U5: TLV75801PDBV; SOT-23-5; LCSC C2877852
U6: Heepocrates; QFN40P1000X1000X80-89N-D
VR1: TC42X-2-203E; TC42X2103E; Mouser Part Number 652-TC42X-2-203E

Connections:
+3V3: C107.2, C108.2, C113.2, C115.2, C117.2, C119.2, C121.2, C124.1, IC4.1 (IN), IC25.5 (DIR3), IC25.14 (VCCA), IC25.15 (DIR1), IC25.16 (DIR2), IC26.5 (DIR3), IC26.6 (DIR4), IC26.14 (VCCA), IC26.15 (DIR1), IC26.16 (DIR2), IC27.14 (VCCA), IC27.15 (DIR1), IC28.6 (DIR4), IC28.14 (VCCA), IC28.15 (DIR1), IC28.16 (DIR2), IC29.5 (DIR3), IC29.14 (VCCA), IC29.15 (DIR1), IC29.16 (DIR2), IC31.6 (VCC), J24.12, J25.20, J25.22, J26.2, J26.4, R51.2, U5.1 (IN)
BOOT_SELECT_HEEP: IC29.11 (B2), R46.2, U6.86 (boot_select_i)
CLK_HEEP: IC24.2 (CLK_OUT), U6.12 (ref_clk_i)
CSB1: J25.11, J26.13
FCLK: J25.15, J26.9
FLASH_CS: IC30.1 (/CS), R47.1, U6.9 (spi_flash_cs_0_io)
FLASH_MISO: IC30.2 (DO_(IO1)), U6.6 (spi_flash_sd_1_io)
FLASH_MOSI: IC30.5 (DI_(IO0)), U6.5 (spi_flash_sd_0_io)
FLASH_SCK: IC30.6 (CLK), R50.1, U6.10 (spi_flash_sck_io)
FLASH_nHLD_nRST: IC30.7 (/HOLD_OR_/RESET_(IO3)), R49.1, U6.8 (spi_flash_sd_3_io)
FLASH_nWP: IC30.3 (/WP_(IO2)), R48.1, U6.7 (spi_flash_sd_2_io)
FLL_CLK_DIV: TP73.1, U6.15 (fll_clk_div_io)
GNDS: C96.1, C97.1, C98.1, C99.1, C100.1, C101.1, C102.1, C103.1, C104.1, C105.1, C106.1, C107.1, C108.1, C109.1, C110.1, C111.1, C112.2, C113.1, C114.2, C115.1, C116.2, C117.1, C118.2, C119.1, C120.2, C121.1, C122.2, C123.1, C124.2, IC4.2 (GND), IC24.1 (GND_1), IC24.4 (GND_2), IC25.6 (DIR4), IC25.7 (~OE), IC25.8 (GND), IC26.7 (~OE), IC26.8 (GND), IC27.7 (~OE), IC27.8 (GND), IC28.5 (DIR3), IC28.7 (~OE), IC28.8 (GND), IC29.6 (DIR4), IC29.7 (~OE), IC29.8 (GND), IC30.4 (GND), IC31.3 (GND), J24.1, J25.21, J25.23, J25.MP1, J25.MP2, J26.1, J26.3, J26.MP1, J26.MP2, J27.7, J27.8, R45.1, U5.2 (GND), U6.2 (VSS_HEEP1), U6.4 (VSSIO6), U6.20 (VSSIO5), U6.22 (VSS_HEEP4), U6.34 (VSSIO4), U6.36 (VSS_HEEP3), U6.47 (VSSIO3), U6.49 (bladetest_gnd), U6.50 (bladetest_vdd3), U6.51 (bladetest_vdd2), U6.52 (bladetest_vdd1), U6.59 (cgra_gnd2), U6.63 (VSSIO2), U6.69 (cgra_gnd1), U6.75 (VSS_HEEP2), U6.77 (VSSIO1), U6.84 (bypass_fll_i), U6.85 (execute_from_flash_i), U6.89 (GND)
GPIO0: IC26.12 (B1), U6.74 (gpio_0_io)
GPIO1: IC26.11 (B2), U6.73 (gpio_1_io)
GPIO2: IC26.10 (B3), U6.72 (gpio_2_io)
GPIO3: IC26.9 (B4), U6.71 (gpio_3_io)
GPIO4: J24.2, U6.68 (gpio_4_io)
GPIO5: J24.3, U6.67 (gpio_5_io)
GPIO6: J24.4, U6.66 (gpio_6_io)
GPIO7: J24.5, U6.65 (gpio_7_io)
I2C_SCL_HEEP: J24.6, U6.88 (i2c_scl_io)
I2C_SDA_HEEP: J24.7, U6.87 (i2c_sda_io)
JTAG_RESET: IC27.12 (B1), U6.81 (jtag_trst_ni)
JTAG_TCK: IC28.12 (B1), U6.83 (jtag_tck_i)
JTAG_TDI: IC28.9 (B4), U6.80 (jtag_tdi_i)
JTAG_TDO: IC29.9 (B4), U6.79 (jtag_tdo_o)
JTAG_TMS: IC29.12 (B1), U6.82 (jtag_tms_i)
unnamed: R44.1, U5.4 (FB), VR1.2 (WIPER)
unnamed: R45.2, VR1.3 (CW)
P_BOOT_SELECT: IC29.2 (A2), J27.11
P_RESET: IC27.1 (A1), IC31.1 (A), J27.4, R51.1
RX0: IC28.3 (A3), J27.14
RX0_HEEP: IC28.11 (B2), U6.13 (uart_rx_i)
Reset: IC31.2 (B), J25.12, J26.12
SCL: J25.1, J26.23
SCLK: J25.5, J26.19
SDA: J25.3, J26.21
SDI: J25.7, J26.17
SDO: J25.9, J26.15
SPI_CS_HEEP: IC25.12 (B1), J24.9, U6.28 (spi_cs_0_io)
SPI_MISO_HEEP: IC25.9 (B4), J24.10, U6.24 (spi_sd_1_io)
SPI_MOSI_HEEP: IC25.10 (B3), J24.11, U6.23 (spi_sd_0_io)
SPI_SCK_HEEP: IC25.11 (B2), J24.8, U6.29 (spi_sck_io)
Start: IC4.3 (EN), IC26.1 (A1), J25.10, J26.14, U5.3 (EN)
TCK: IC28.1 (A1), J27.2
TDI: IC28.4 (A4), J27.13
TDO: IC29.4 (A4), J27.3
TMS: IC29.1 (A1), J27.12
TX0: IC28.2 (A2), J27.1
TX0_HEEP: IC28.10 (B3), U6.14 (uart_tx_o)
USB_GP1: IC25.1 (A1), J25.2, J26.22
USB_GP2: IC25.2 (A2), J25.4, J26.20
USB_GP3: IC25.3 (A3), J25.6, J26.18
USB_GP4: IC25.4 (A4), J25.8, J26.16
USB_GP5: IC26.2 (A2), J25.13, J26.11
USB_GP6: IC26.3 (A3), J25.17, J26.7
USB_GP7: IC26.4 (A4), J25.19, J26.5
VDD: C96.2, C97.2, C99.2, C101.2, C103.2, C105.2, C109.2, C112.1, C114.1, C116.1, C118.1, C120.1, C122.1, C123.2, IC4.5 (OUT), IC24.3 (VDD), IC25.13 (VCCB), IC26.13 (VCCB), IC27.13 (VCCB), IC28.13 (VCCB), IC29.13 (VCCB), IC30.8 (VCC), R46.1, R47.2, R48.2, R49.2, R50.2, TP73.1, U6.3 (VDDIO6), U6.19 (VDDIO5), U6.33 (VDDIO4), U6.48 (VDDIO3), U6.64 (VDDIO2), U6.78 (VDDIO1)
nRST_HEEP: IC29.10 (B3), U6.11 (rst_ni)
nRST_LOGIC: IC29.3 (A3), IC31.4 (Y)
vcore_ldo: C98.2, C100.2, C102.2, C104.2, C106.2, C110.2, C111.2, R44.2, TP73.1, U5.5 (OUT), U6.1 (VDD_HEEP1), U6.21 (VDD_HEEP4), U6.35 (VDD_HEEP3), U6.60 (cgra_vdd2), U6.70 (cgra_vdd1), U6.76 (VDD_HEEP2)

Notes on the sheet:
BUS transcivers
SPI pins: SD_0--- MOSI SD_1--- MISO CS_0--- CS SCK_io---SCK
Reset logic (Programmer reset or Nordic SoC reset).
Vfb=0.55V Vout=Vfb(1+R1/R2) R1/R2=Vout/Vfb-1 R1=2k, R2=1.69k, Vout=1.2V R1=2k, R2=22k, Vout=0.6V
Heepo (Versasens main board extension)
Test Points
Buttom Connectors
2x UART, RISC-V JTAG
Debugging pins: 1. FLL_CLK_DIV_IO output for debugging (Not used) 2. EXIT_VALID_0 debug pins (Not used) 3. Exit_VALUE_0 debug pins (Not used)
Clock generation and control
Flash Memory
Programming pins: 1. BYPASS_FLL_I (Not used GND) 2. EXEC_FROM_FLASH_I (Not used GND) 3. BOOT_SELECT_I (Pull up resistor and connected to A5 pin of the JTAG)
Mounting Holes
Connectors
LDOs
HEEPocrates
Top Connectors
20K single turn trimmer.
1.8V Power Supply
FFC Connectors
