esl-epfl/VersaSens/VersaSens_FW/src/drivers/T5838.c

/*
                              *******************
******************************* C SOURCE FILE *******************************
**                            *******************                          **
**                                                                         **
** project  : VersaSens                                                    **
** filename : T5838.c                                                      **
** version  : 1                                                            **
** date     : DD/MM/YY                                                     **
**                                                                         **
*****************************************************************************
**                                                                         **
** Copyright (c) EPFL                                                      **
** All rights reserved.                                                    **
**                                                                         **
*****************************************************************************
	 
VERSION HISTORY:
----------------
Version     : 1
Date        : 10/02/2021
Revised by  : Benjamin Duc
Description : Original version.


*/

/***************************************************************************/
/***************************************************************************/

/**
* @file   T5838.c
* @date   DD/MM/YY
* @brief  This is the main header of T5838.c
*
* Here typically goes a more extensive explanation of what the header
* defines.
*/

#define _T5838_C_SRC

/****************************************************************************/
/**                                                                        **/
/*                             MODULES USED                                 */
/**                                                                        **/
/****************************************************************************/

#include "storage.h"
#include <nrfx_uarte.h>
#include <stdlib.h>
#include "T5838.h"
#include <nrfx_pdm.h>
#include <nrfx_clock.h>
#include <zephyr/irq.h>
#include <zephyr/types.h>
#include <zephyr/sys/printk.h>
#include <zephyr/kernel.h>
#include <zephyr/logging/log.h>
#include "versa_time.h"

#include "opus.h"
#include "opus_types.h"
#include "opus_private.h"

/****************************************************************************/
/**                                                                        **/
/*                        DEFINITIONS AND MACROS                            */
/**                                                                        **/
/****************************************************************************/

LOG_MODULE_REGISTER(t5838, LOG_LEVEL_INF);

#define PDM_BUFFER_SIZE        240

#define T5838_PDM(idx)	       DT_NODELABEL(pdm##idx)

/****************************************************************************/
/**                                                                        **/
/*                        TYPEDEFS AND STRUCTURES                           */
/**                                                                        **/
/****************************************************************************/

struct {
    int16_t t5838_frame1[PDM_BUFFER_SIZE];
    int16_t t5838_frame2[PDM_BUFFER_SIZE];
    int16_t t5838_frame3[PDM_BUFFER_SIZE];
}t5838_frames;

/****************************************************************************/
/**                                                                        **/
/*                      PROTOTYPES OF LOCAL FUNCTIONS                       */
/**                                                                        **/
/****************************************************************************/

/**
* @brief This function is the thread function that saves the frames to the fifo buffer
*
* @param arg1 : argument 1, not used
* @param arg2 : argument 2, not used
* @param arg3 : argument 3, not used
*
* @retval None
*/
void t5838_save_thread_func(void *arg1, void *arg2, void *arg3);

/****************************************************************************/
/**                                                                        **/
/*                           EXPORTED VARIABLES                             */
/**                                                                        **/
/****************************************************************************/

int16_t *t5838_frame = NULL;

bool t5838_frame1_new = false;
bool t5838_frame2_new = false;
bool t5838_frame3_new = false;

/****************************************************************************/
/**                                                                        **/
/*                            GLOBAL VARIABLES                              */
/**                                                                        **/
/****************************************************************************/

K_THREAD_STACK_DEFINE(T5838_save_thread_stack, 100000);
struct k_thread T5838_save_thread;

volatile bool T5838_save_stop_thread = false;

T5838_StorageFormat T5838_storage;

/****************************************************************************/
/**                                                                        **/
/*                           EXPORTED FUNCTIONS                             */
/**                                                                        **/
/****************************************************************************/

static void pdm_handler(nrfx_pdm_evt_t const *event)
{
    /*! Check if a buffer is requested */
    if (event->buffer_requested) {
        if (t5838_frame == t5838_frames.t5838_frame1)
        {
            t5838_frame = t5838_frames.t5838_frame2;
        }
        else if (t5838_frame == t5838_frames.t5838_frame2)
        {
            t5838_frame = t5838_frames.t5838_frame3;
        }
        else if (t5838_frame == t5838_frames.t5838_frame3 || t5838_frame == NULL)
        {
            t5838_frame = t5838_frames.t5838_frame1;
        }

        if(event->buffer_released == t5838_frames.t5838_frame1)
        {
            t5838_frame1_new = true;
        }
        else if(event->buffer_released == t5838_frames.t5838_frame2)
        {
            t5838_frame2_new = true;
        }
        else if(event->buffer_released == t5838_frames.t5838_frame3)
        {
            t5838_frame3_new = true;
        }

        nrfx_pdm_buffer_set(t5838_frame, PDM_BUFFER_SIZE);
    }
}

/*****************************************************************************
*****************************************************************************/

int t5838_set_freq(uint32_t freq)
{
    nrfx_err_t status;
    (void)status; 

    /*! Get the default PDM configuration */
    nrfx_pdm_config_t pdm_config = NRFX_PDM_DEFAULT_CONFIG(PDM_CLK_PIN, PDM_DATA_PIN);
    pdm_config.clock_freq = NRF_PDM_FREQ_1000K / 1000.0 * freq;

    /*! Initialize the PDM peripheral */
    status = nrfx_pdm_reconfigure(&pdm_config);

    return (status == NRFX_SUCCESS)? 0 : -1;
}

/*****************************************************************************
*****************************************************************************/

int t5838_start(void)
{
    nrfx_err_t status;
    (void)status; 

    /*! Start the PDM peripheral */
    status = nrfx_pdm_start();

    t5838_start_saving();

    return (status == NRFX_SUCCESS)? 0 : -1;
}

/*****************************************************************************
*****************************************************************************/

int t5838_stop(void)
{
    nrfx_err_t status;
    (void)status; 

    t5838_stop_saving();

    /*! Stop the PDM peripheral */
    status = nrfx_pdm_stop();

    return (status == NRFX_SUCCESS)? 0 : -1;
}

/*****************************************************************************
*****************************************************************************/
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
