esl-epfl/VersaSens/(commit log)

2024-08-30 First release
    [47589-0001.step, BM02B-ACHSS-GAN-TF_LF__SN_.step, ECG_PPG.kicad_sch, EDA.kicad_sch, EMG.kicad_sch, Expansion.kicad_sch, Main.kicad_sch, PPG.kicad_sch]
2024-08-30 added Casing
    [EDA_back.stl, EDA_front.stl, Main_front.stl, PPG_back.stl, PPG_front.stl, VersaSens_Design_Compact.step, VersaSens_Design_Compact_back_latch.stl, VersaSens_Design_Compact_front.stl]
2024-09-20 storage and ppg led change
